jvanderberg/pico-stretch2/review3/pack_after/drc.md

| Severity | Type | Count |
|---|---|---|
| warning | lib_footprint_mismatch | 7 |
| warning | silk_over_copper | 1 |

## lib_footprint_mismatch (warning, 7)
- Footprint 'PinHeader_1x03_P2.54mm_Vertical' does not match copy in library 'Connector_PinH: Footprint J2 @ (160.35, 98.91)
- Footprint 'C_0603_1608Metric' does not match copy in library 'Capacitor_SMD': Footprint C40 @ (122.45, 101.60)
- Footprint 'C_0603_1608Metric' does not match copy in library 'Capacitor_SMD': Footprint C37 @ (118.86, 103.90)
- Footprint 'R_0402_1005Metric' does not match copy in library 'Resistor_SMD': Footprint R3 @ (119.99, 101.30)
- Footprint 'RCLAMP0521P_TCT_C3029033' does not match copy in library 'EasyEDA': Footprint D3 @ (118.05, 101.92)
- Footprint 'TYPE-C_16PIN_2MD_073' does not match copy in library 'EasyEDA': Footprint USB1 @ (113.56, 101.06)
- Footprint 'C_0402_1005Metric' does not match copy in library 'Capacitor_SMD': Footprint C39 @ (117.85, 103.08)

## silk_over_copper (warning, 1)
- Silkscreen clipped by solder mask: Segment of U3 on Top Silkscreen Layer @ (120.76, 102.00); Pad 2 [3V3] of C40 on Top Layer @ (121.67, 101.60)
