jvanderberg/pico-stretch2/images/pcb-layout-bottom.jpg

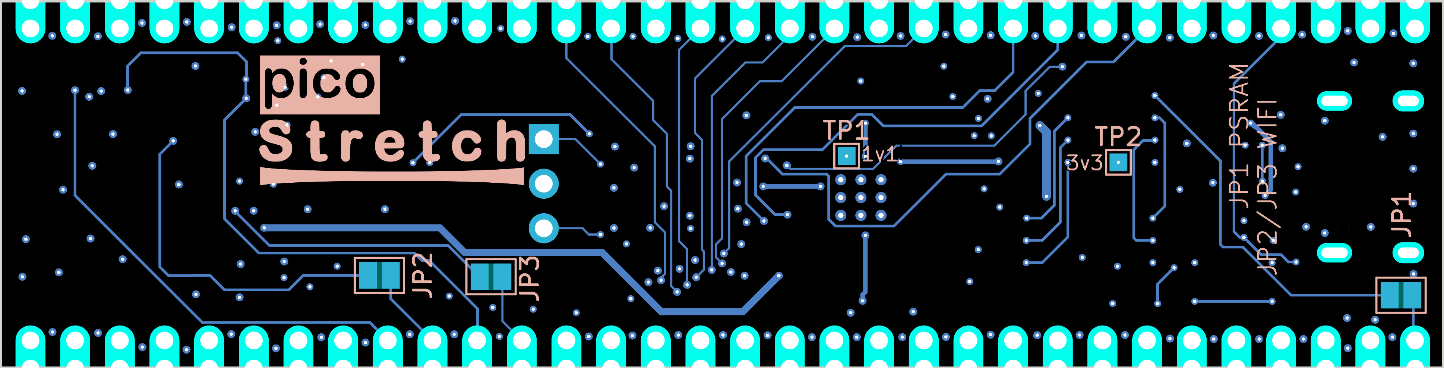
images/pcb-layout-bottom.jpg
