jvanderberg/pico-stretch2/images/pcb-layout-top.jpg

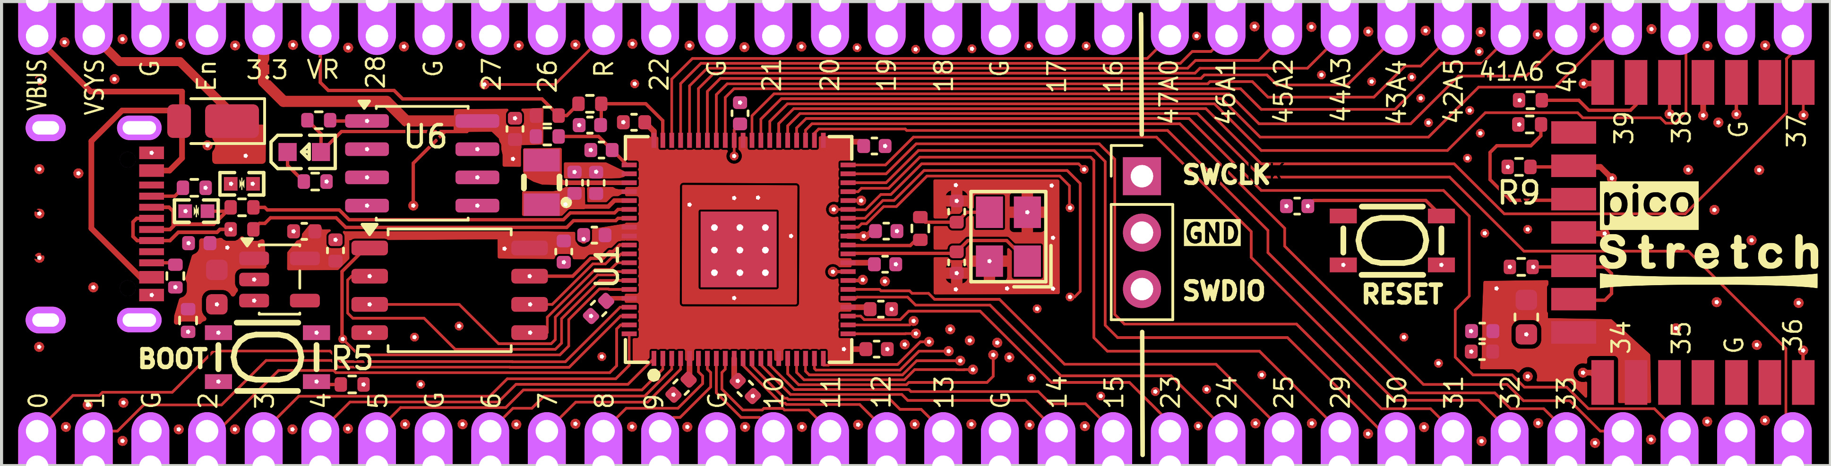
images/pcb-layout-top.jpg
