jvanderberg/pico-stretch2/review2/renders/in1_vreg.png

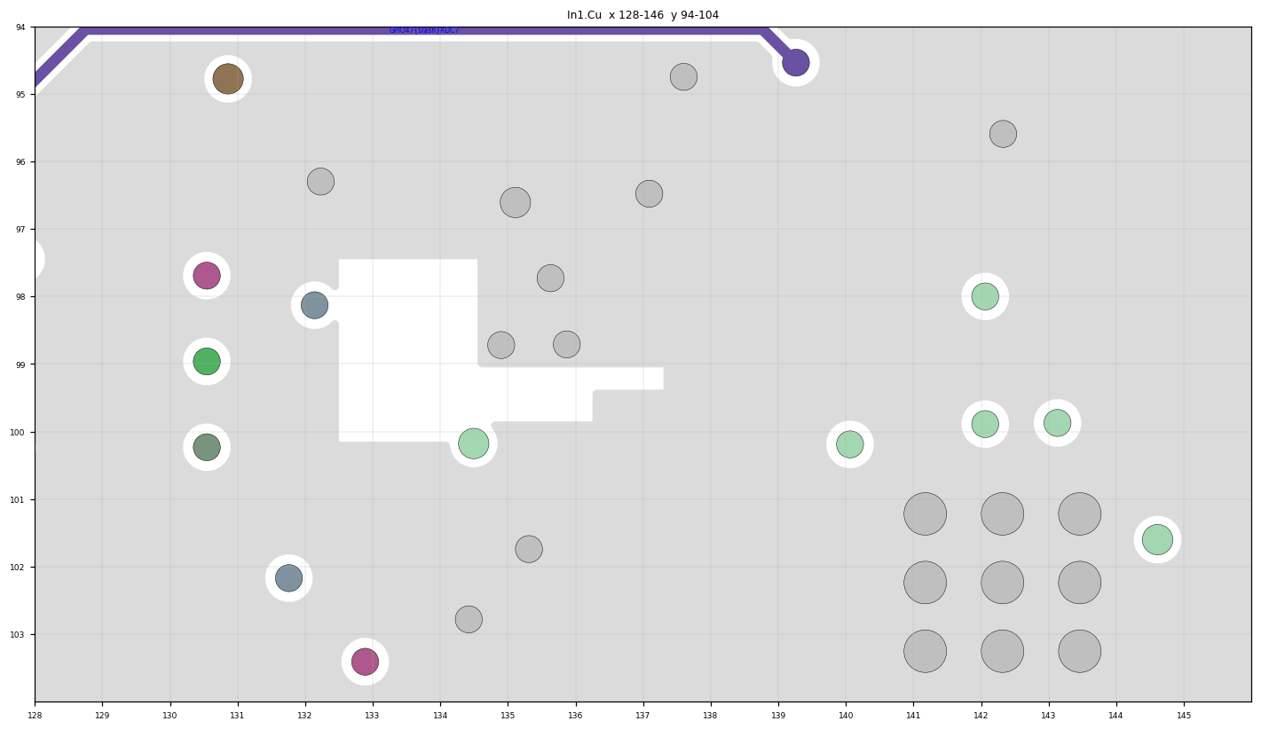
review2/renders/in1_vreg.png
