jvanderberg/pico-stretch2/review2/renders/silk_b_jp1_0.png

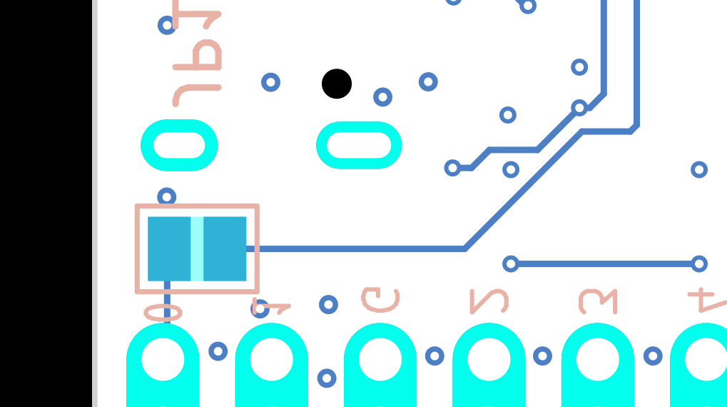
review2/renders/silk_b_jp1_0.png
