jvanderberg/pico-stretch2/review2/renders/silk_b_jp23.png

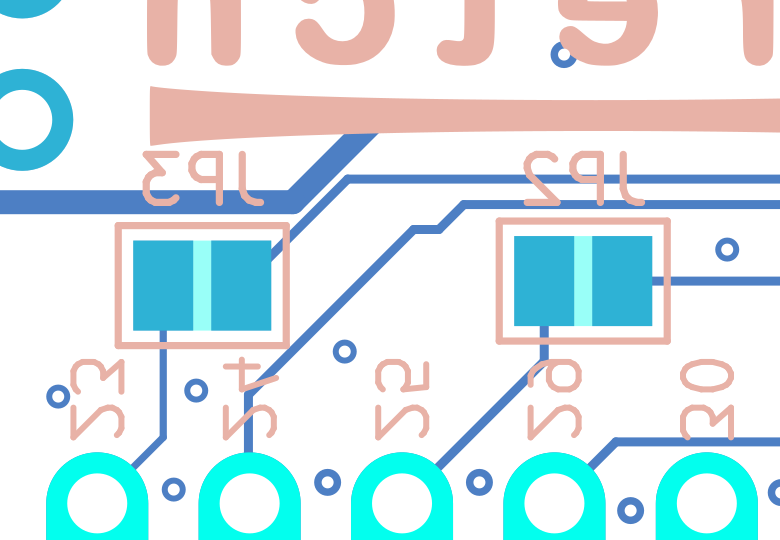
review2/renders/silk_b_jp23.png
