jvanderberg/pico-stretch2/review2/renders/silk_f_40A0.png

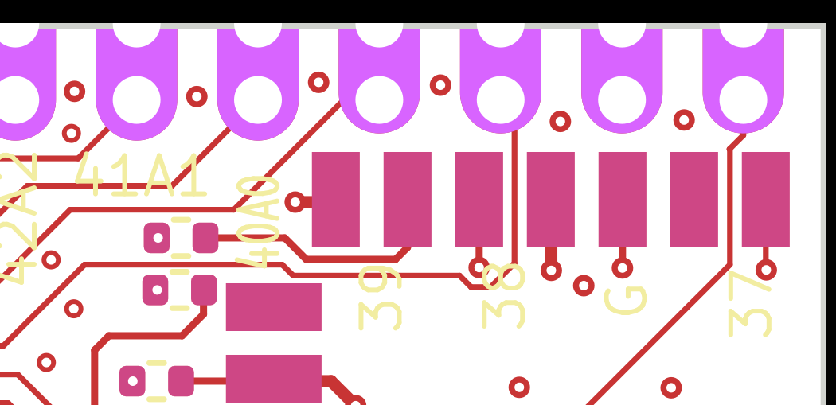
review2/renders/silk_f_40A0.png
