jvanderberg/pico-stretch2/review2/renders/silk_f_usb.png

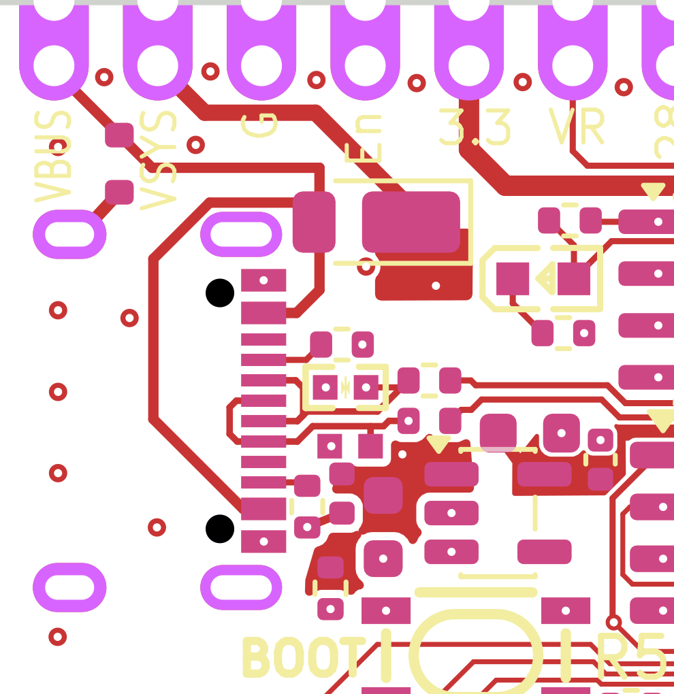
review2/renders/silk_f_usb.png
