jvanderberg/pico-stretch2/review2/renders/u1_p50_c13.png

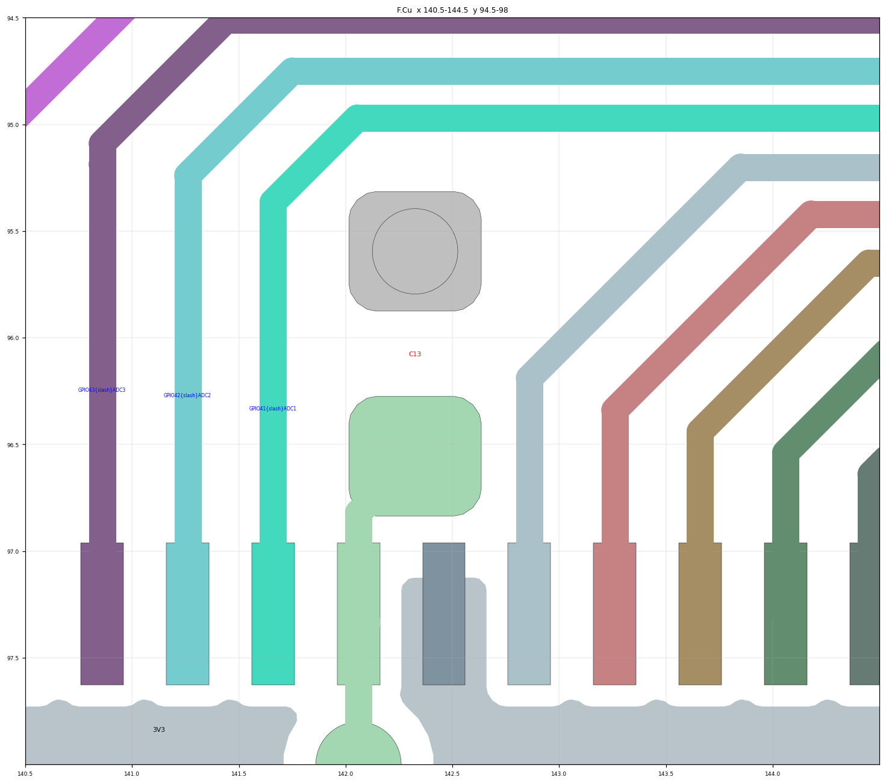
review2/renders/u1_p50_c13.png
