jvanderberg/pico-stretch2/review2/renders/u6_fcu.png

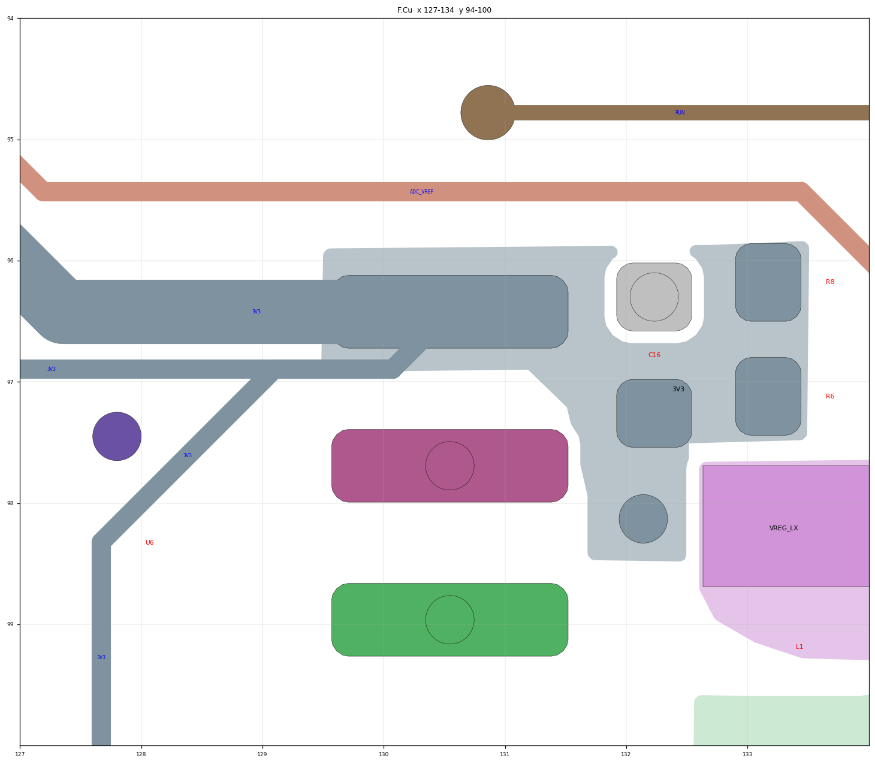
review2/renders/u6_fcu.png
