jvanderberg/pico-stretch2/review2/renders/usb_bcu.png

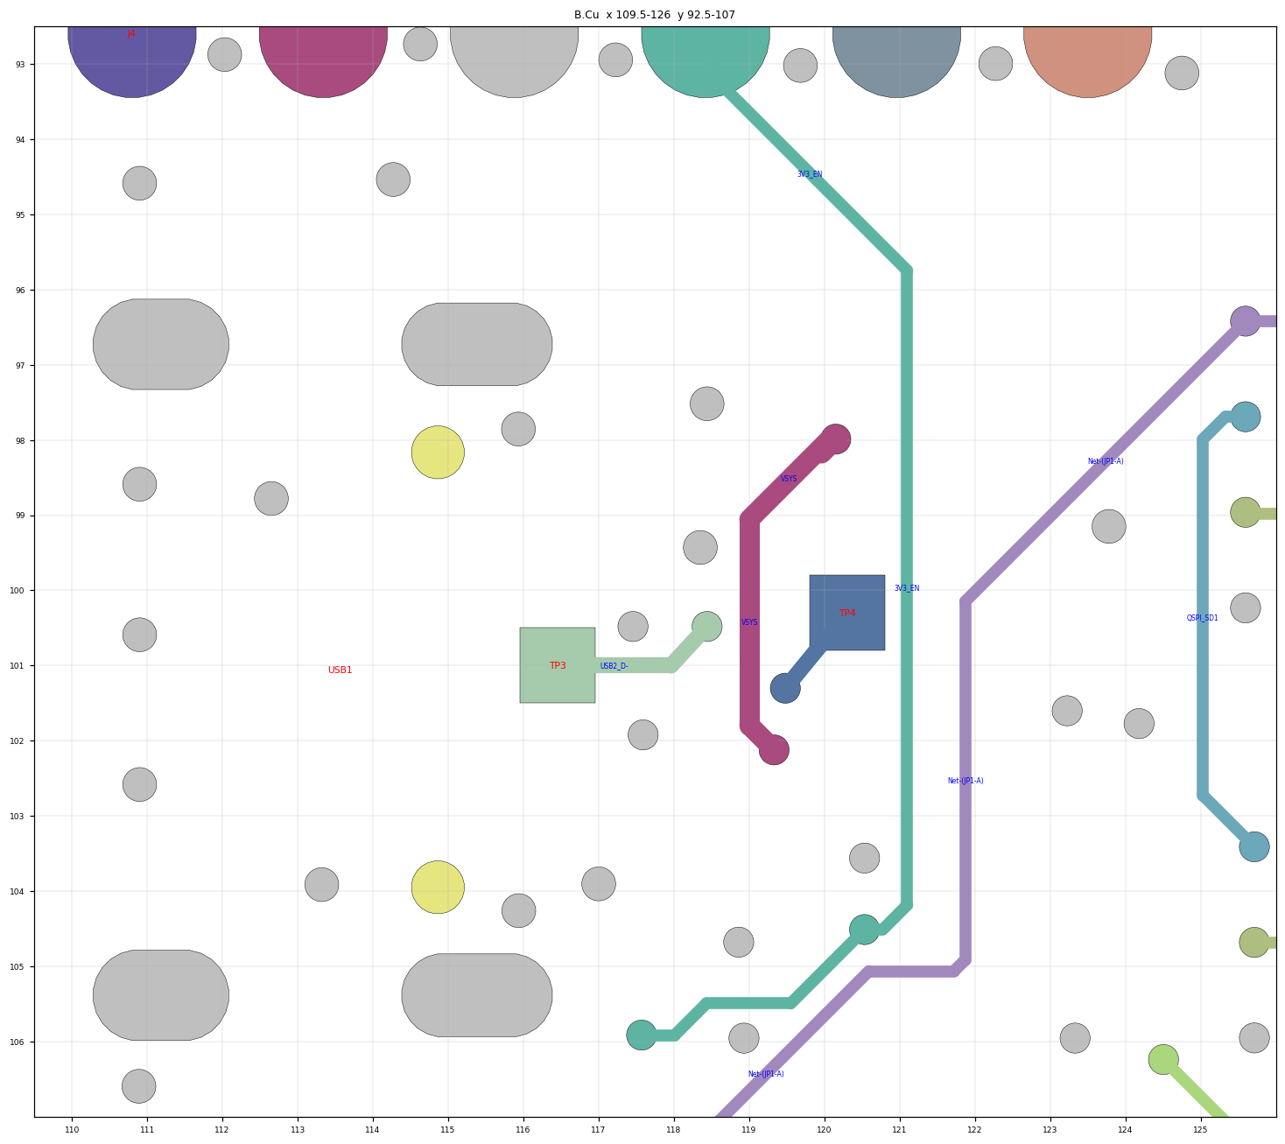
review2/renders/usb_bcu.png
