jvanderberg/pico-stretch2/review2/renders/usb_fcu.png

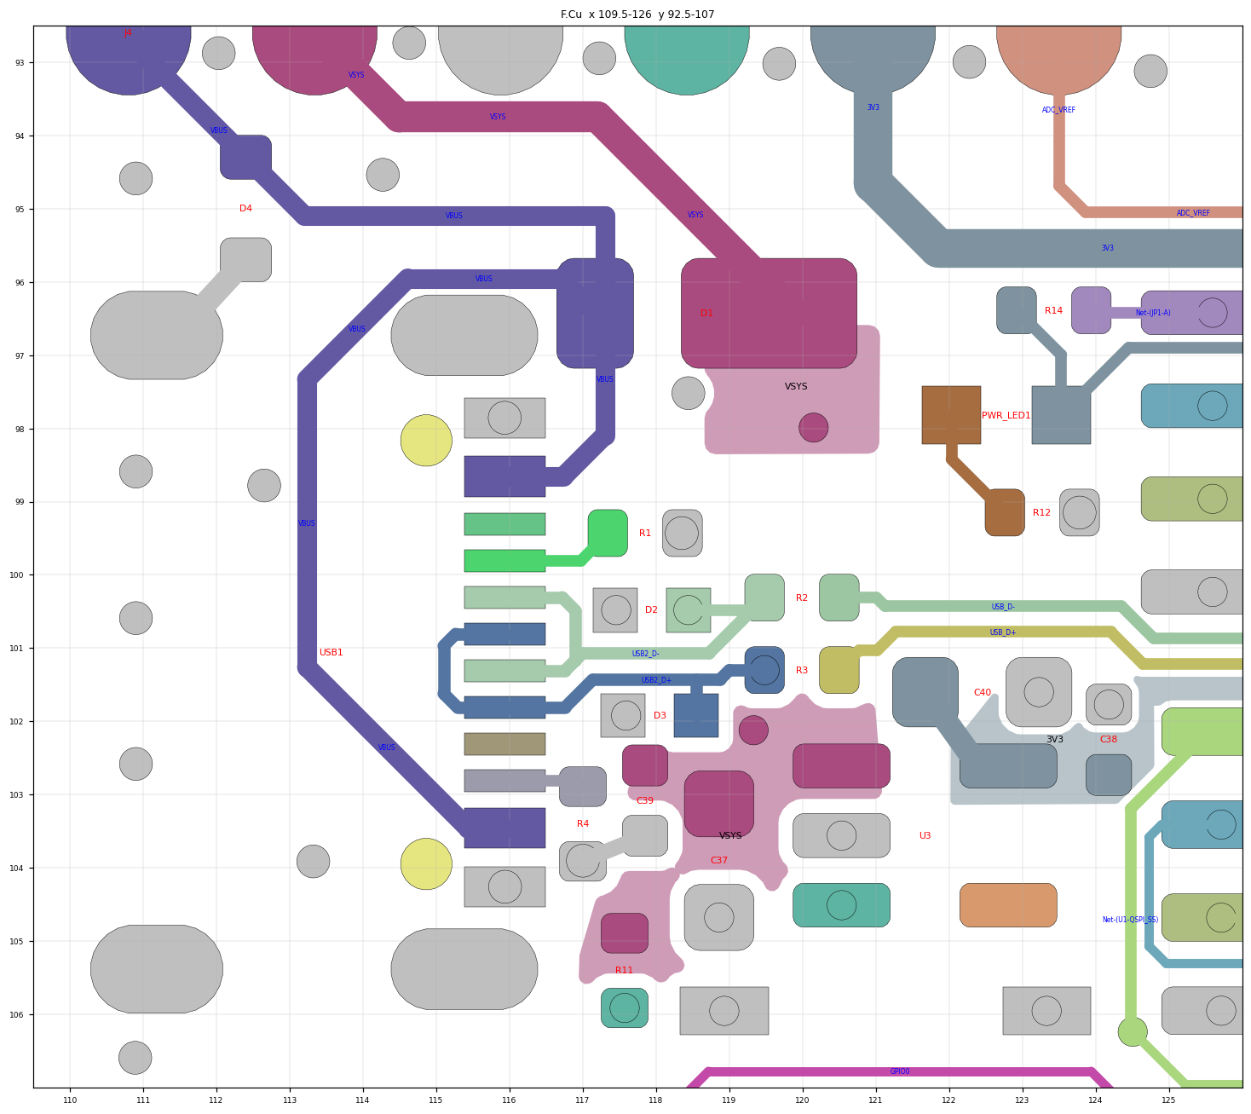
review2/renders/usb_fcu.png
