jvanderberg/pico-stretch2/review2/renders/usb_in1.png

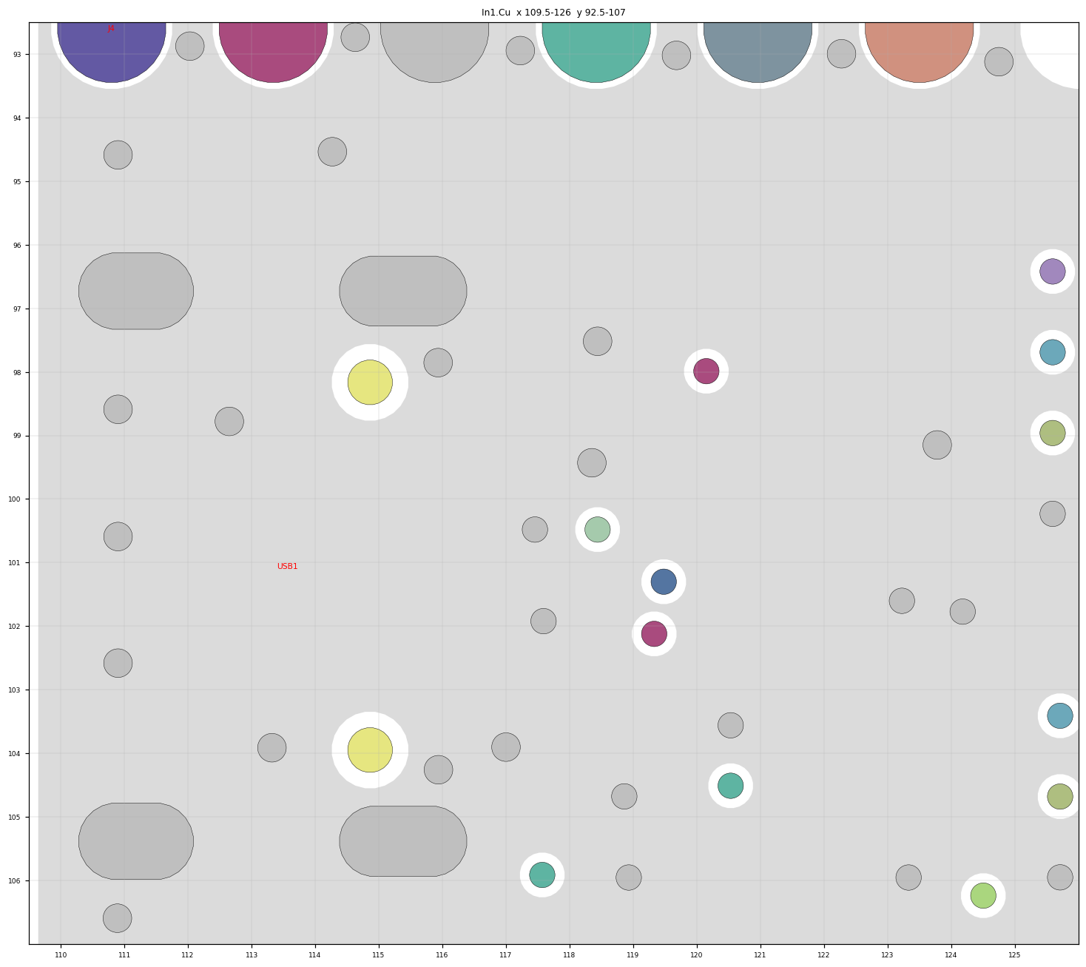
review2/renders/usb_in1.png
