jvanderberg/pico-stretch2/review2/renders/vreg_fcu.png

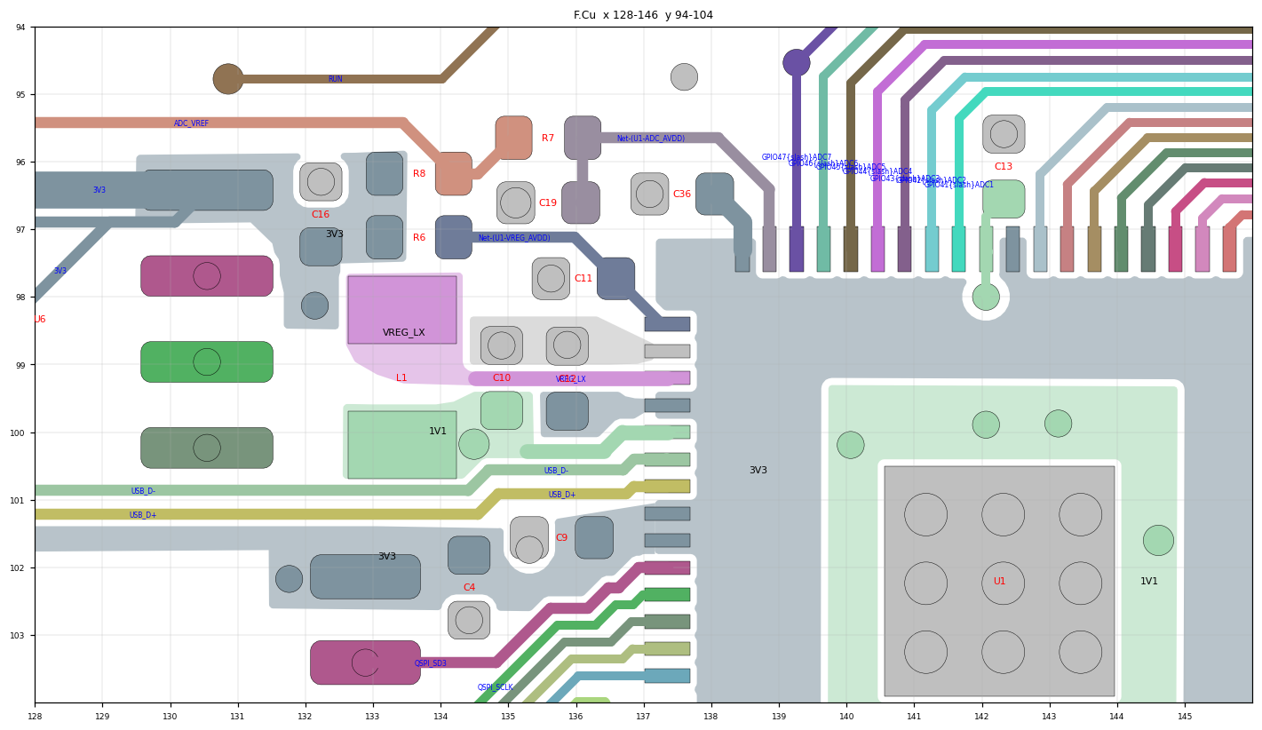
review2/renders/vreg_fcu.png
