jvanderberg/pico-stretch2/review3/pack/maps/gnd_return_inner_15.2um.png

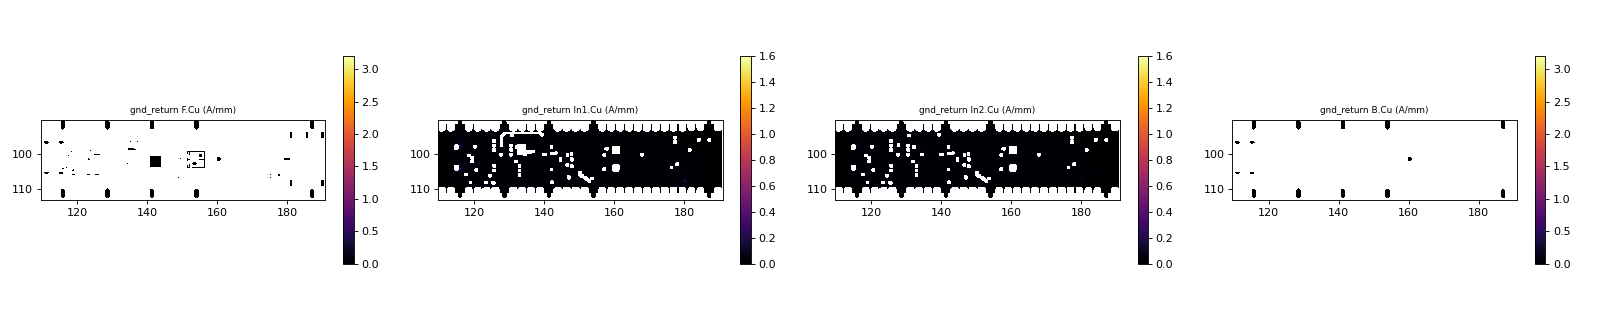
review3/pack/maps/gnd_return_inner_15.2um.png
