jvanderberg/pico-stretch2/review3/pack/maps/p1v1_inner_15.2um.png

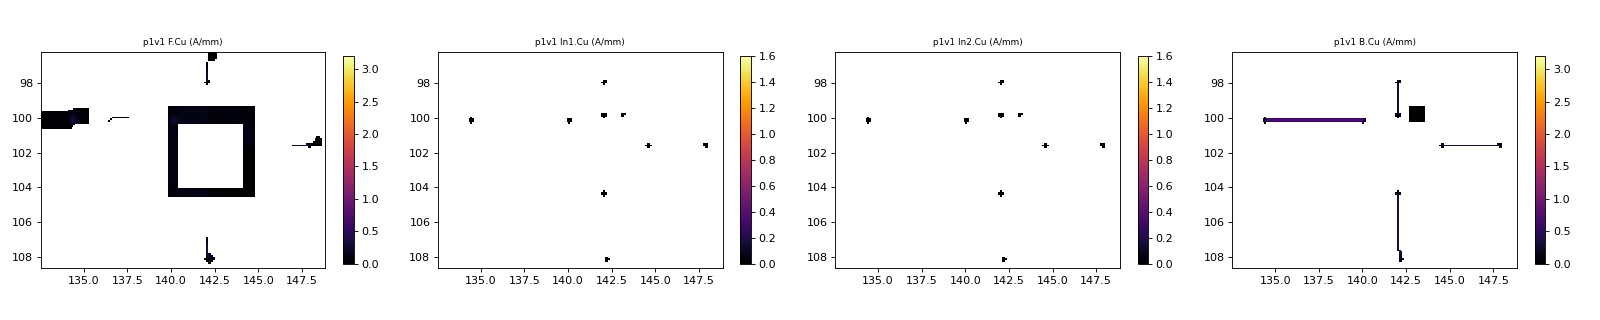
review3/pack/maps/p1v1_inner_15.2um.png
