jvanderberg/pico-stretch2/review3/pack/maps/p3v3_inner_15.2um.png

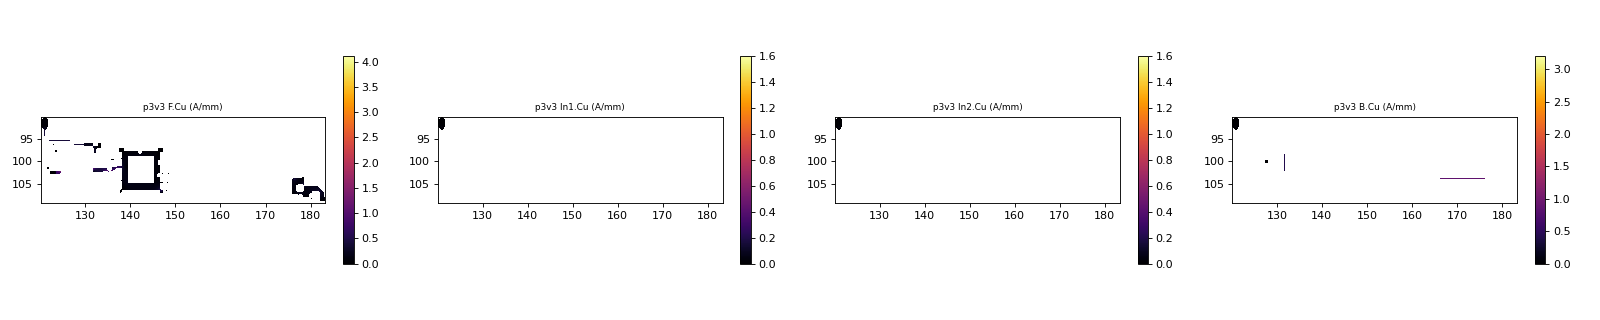
review3/pack/maps/p3v3_inner_15.2um.png
