jvanderberg/pico-stretch2/review3/pack/maps/thermal_radio_tx.png

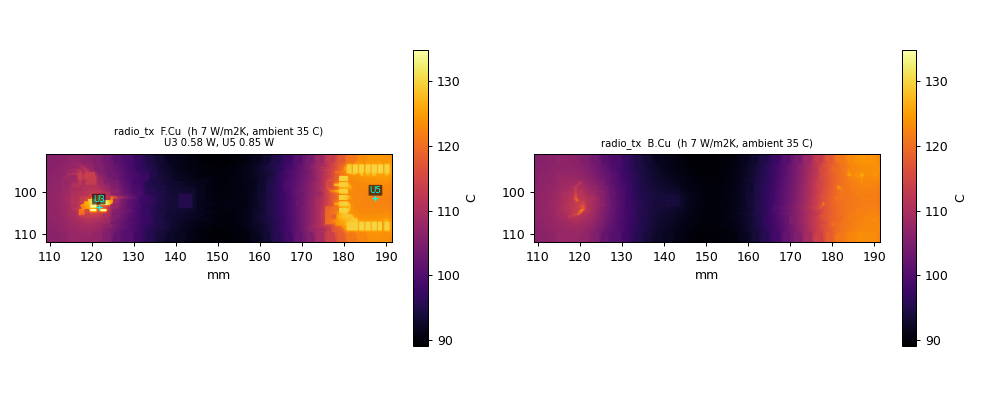
review3/pack/maps/thermal_radio_tx.png
