jvanderberg/pico-stretch2/review3/pack/maps/thermal_typical.png

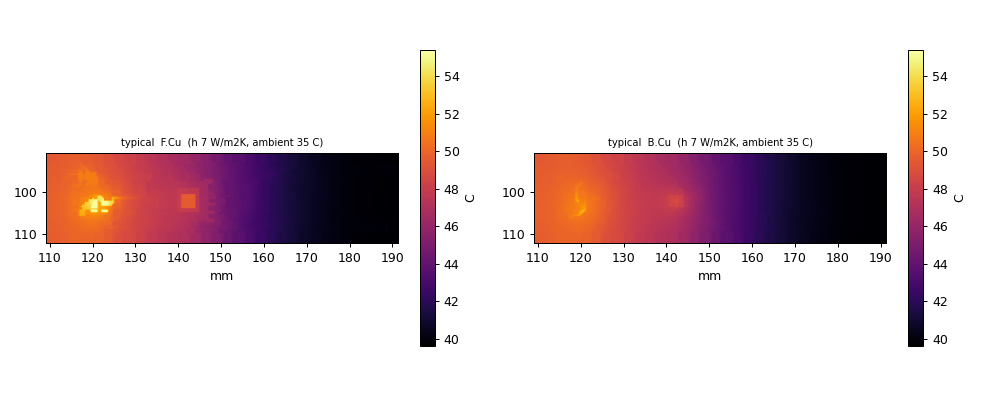
review3/pack/maps/thermal_typical.png
