jvanderberg/pico-stretch2/review3/pack/maps/vbus_inner_15.2um.png

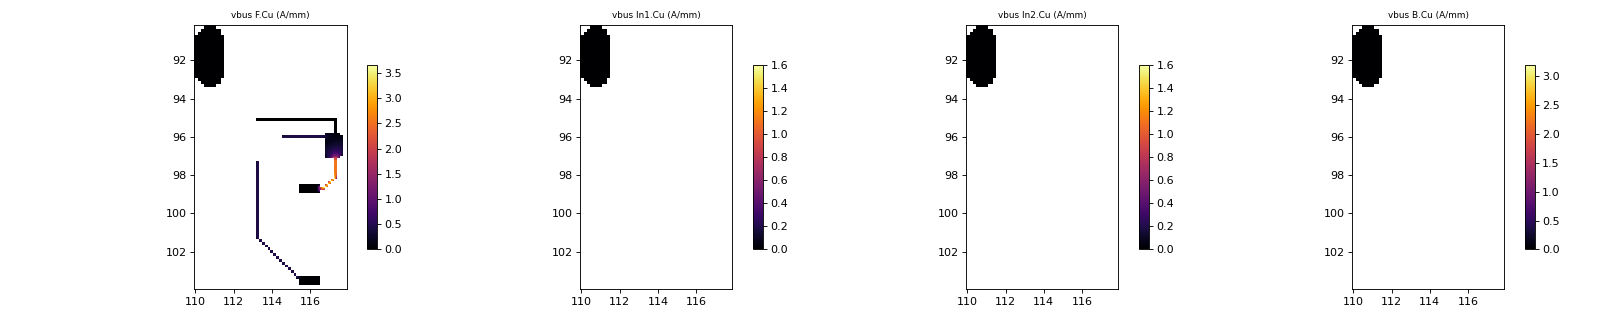
review3/pack/maps/vbus_inner_15.2um.png
