jvanderberg/pico-stretch2/review3/renders/bottom3d.png

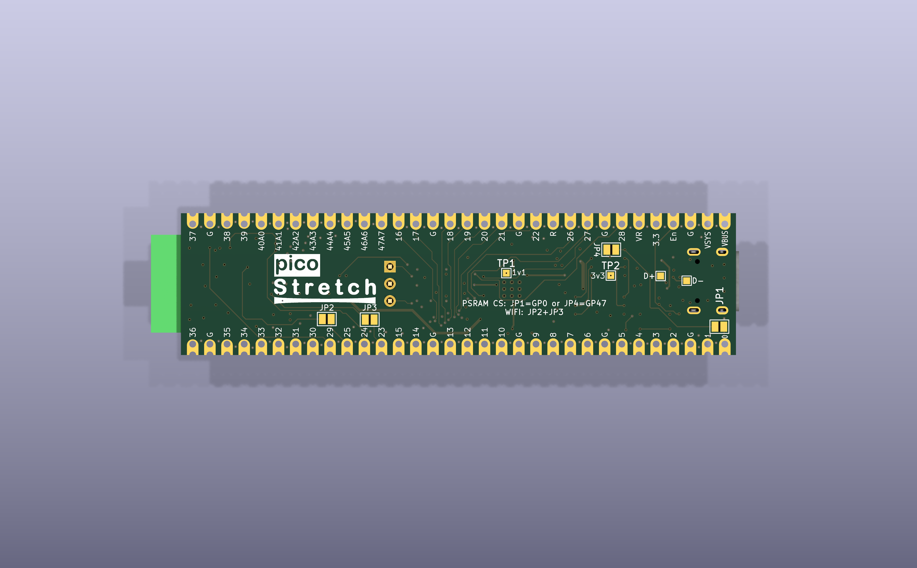
review3/renders/bottom3d.png
