jvanderberg/pico-stretch2/review3/renders/pico_tp_back.png

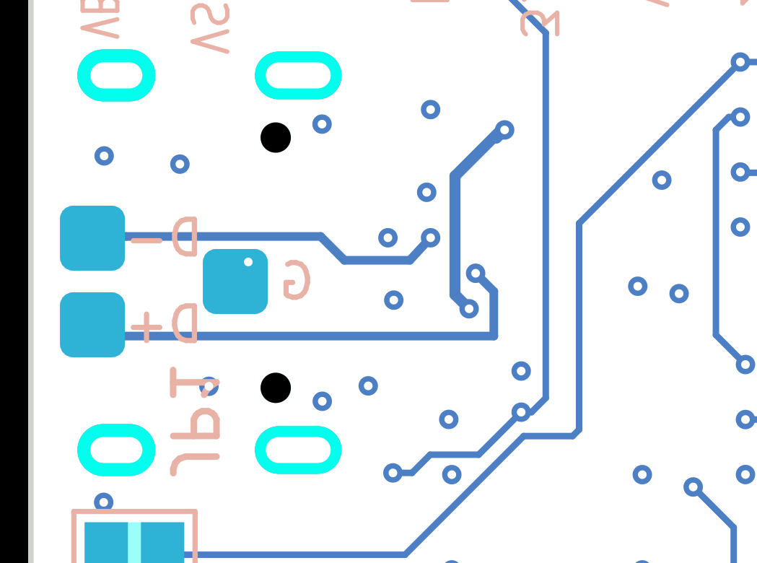
review3/renders/pico_tp_back.png
