jvanderberg/pico-stretch2/review3/renders/top3d.png

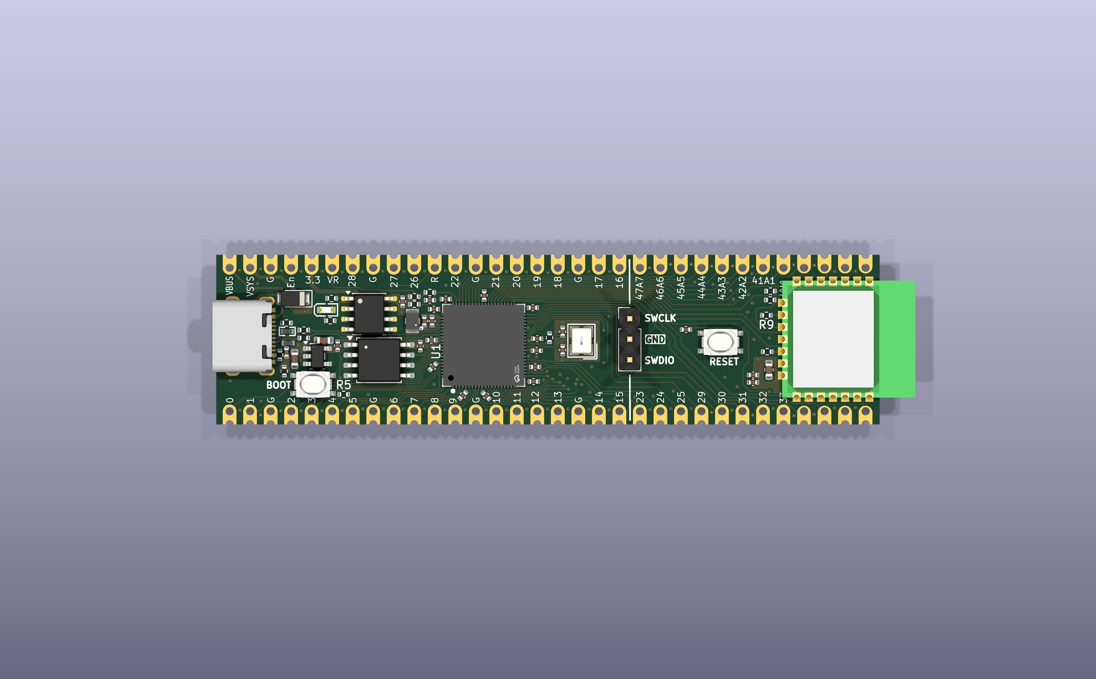
review3/renders/top3d.png
