jvanderberg/pico-stretch2/review3/renders/usb_end_bcu.png

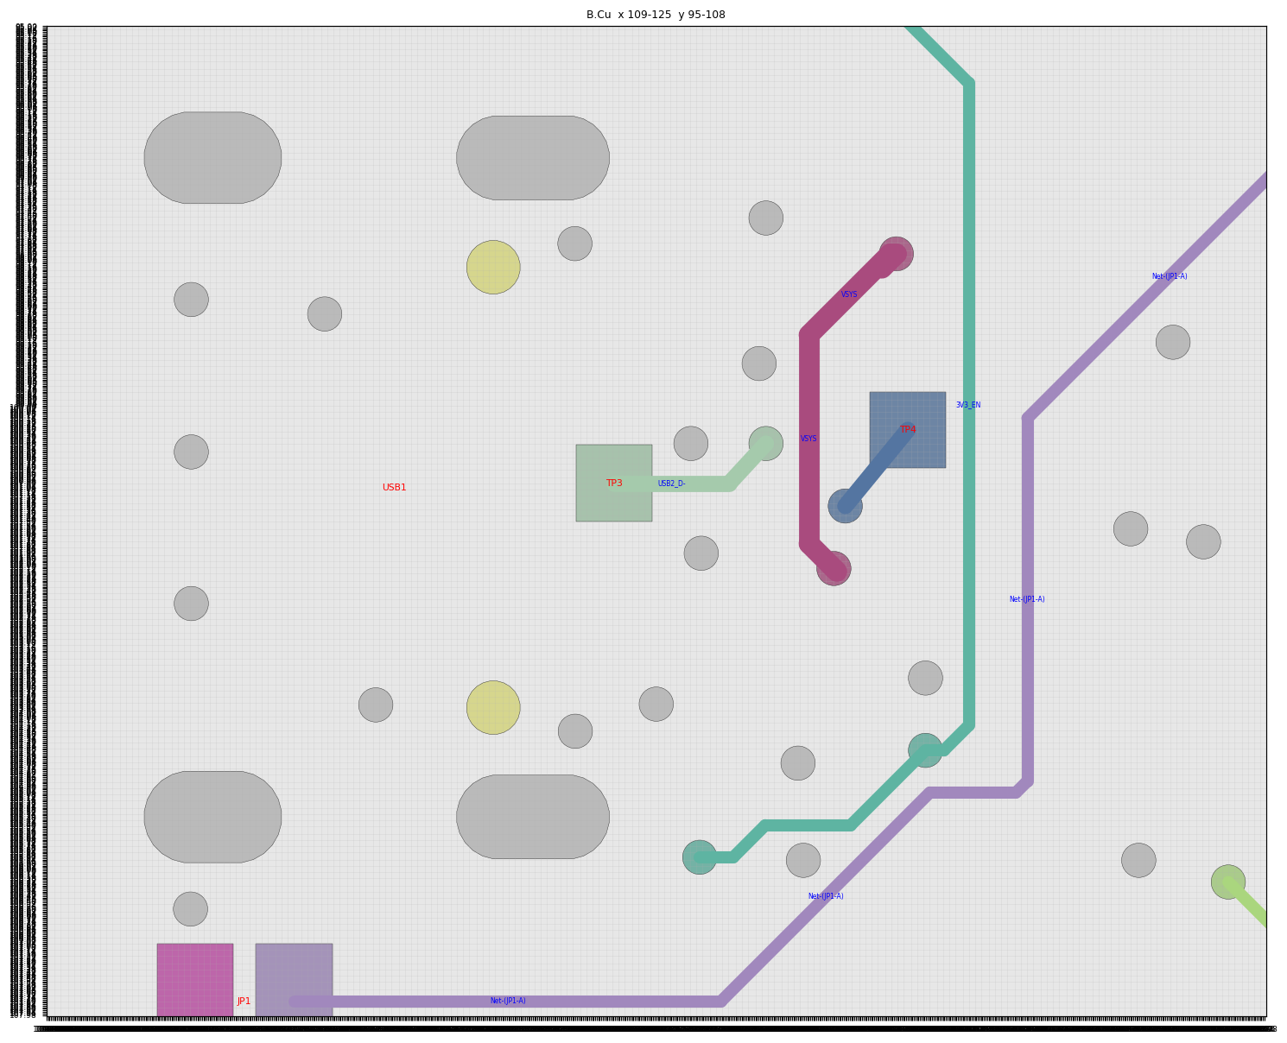
review3/renders/usb_end_bcu.png
