jvanderberg/pico-stretch2/review3/renders/usb_end_fcu.png

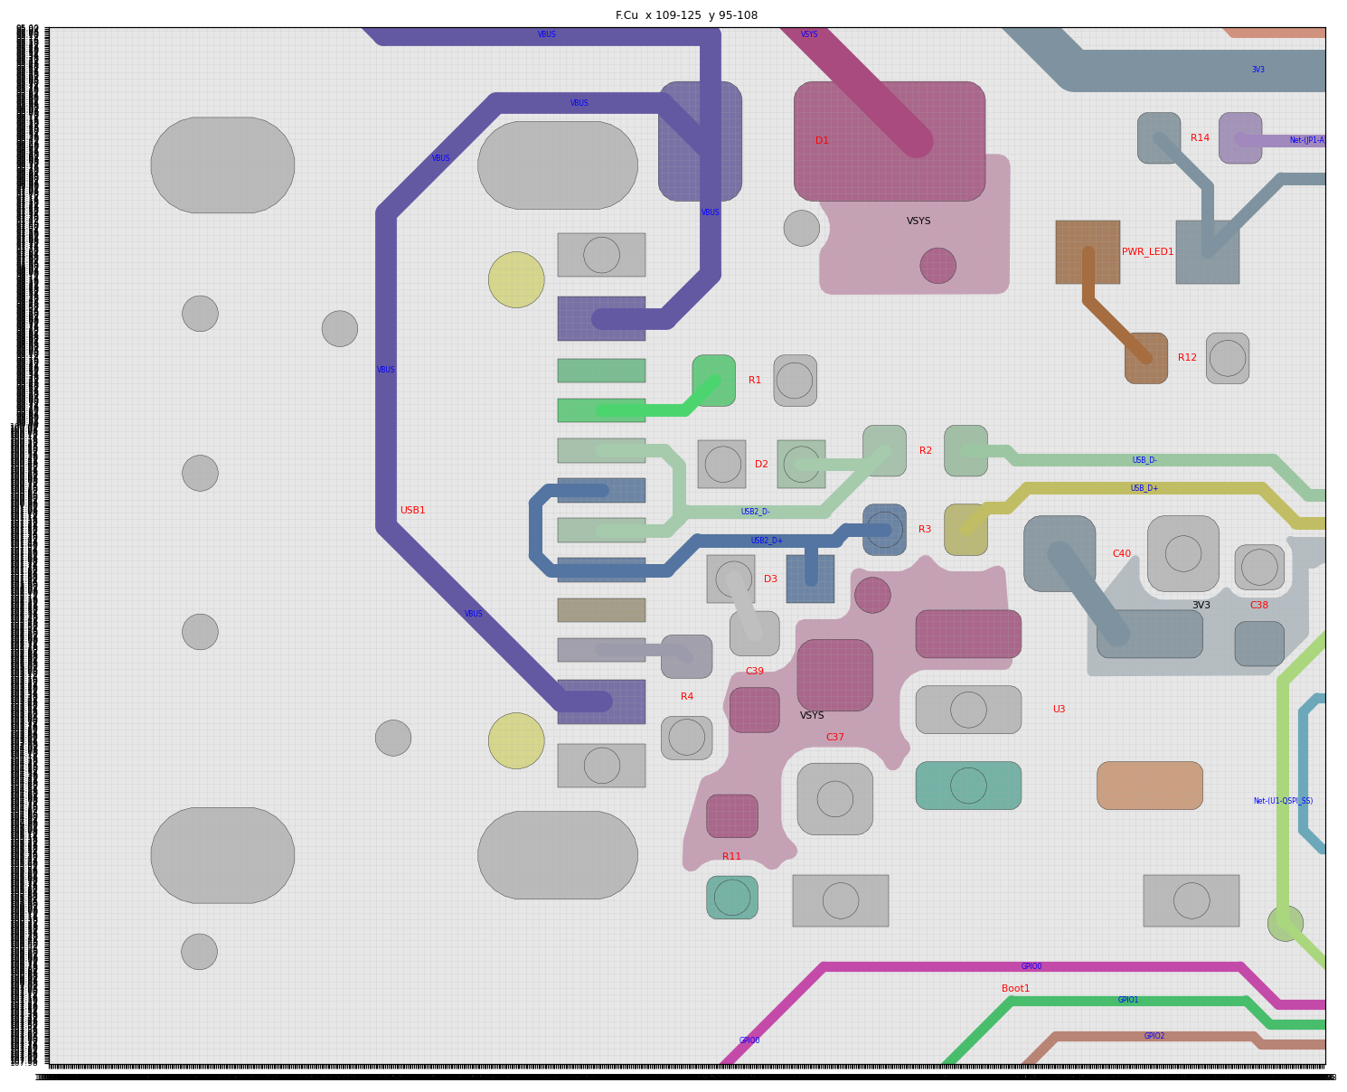
review3/renders/usb_end_fcu.png
