jvanderberg/pico-stretch2/review/renders/back_silk_L.png

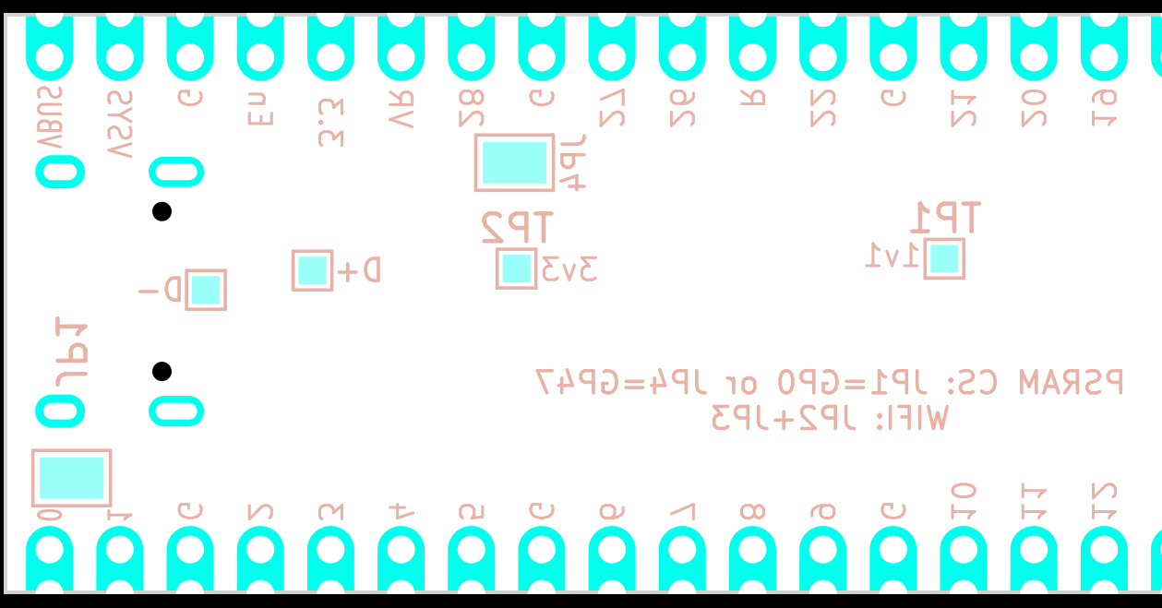
review/renders/back_silk_L.png
