jvanderberg/pico-stretch2/review/renders/back_silk_R.png

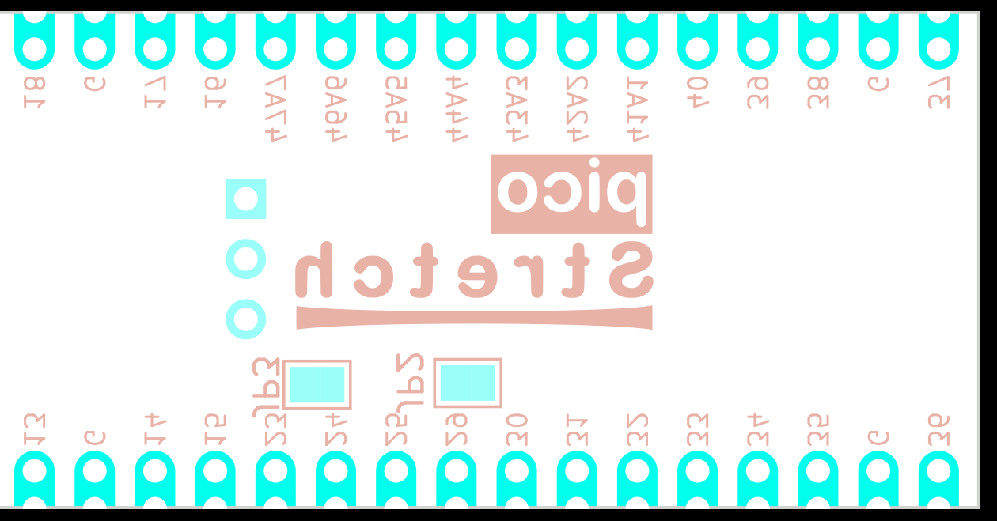
review/renders/back_silk_R.png
