jvanderberg/pico-stretch2/review/renders/front_silk_L.png

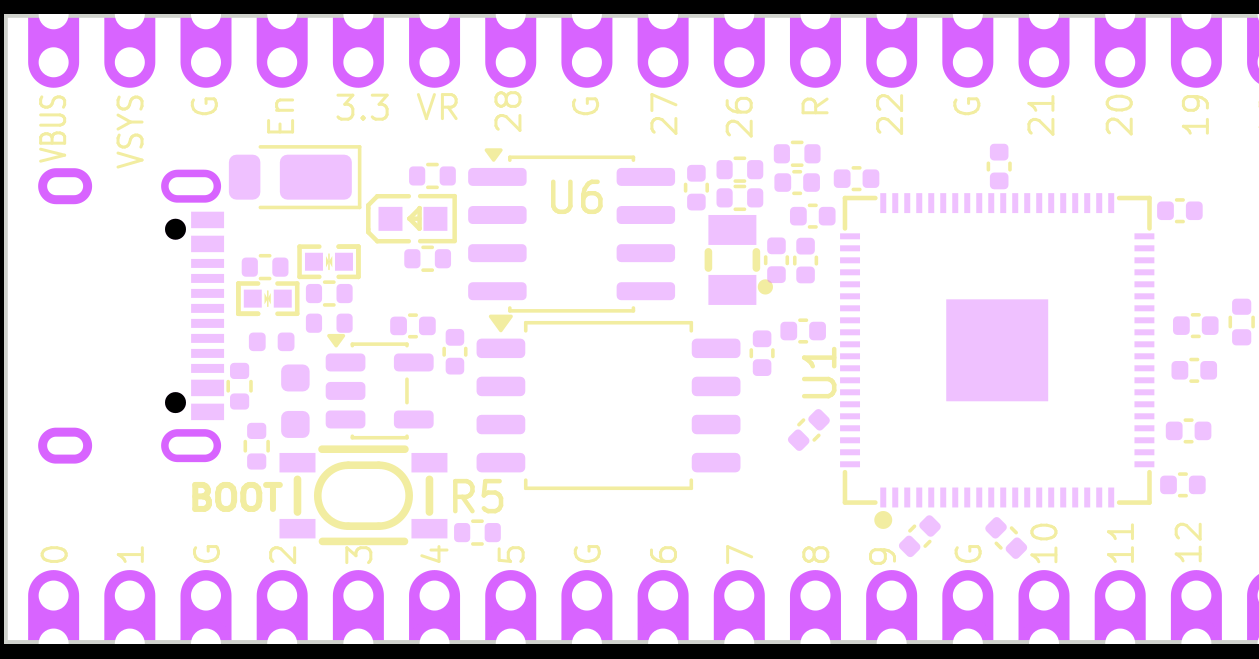
review/renders/front_silk_L.png
