jvanderberg/pico-stretch2/review/renders/front_silk_R.png

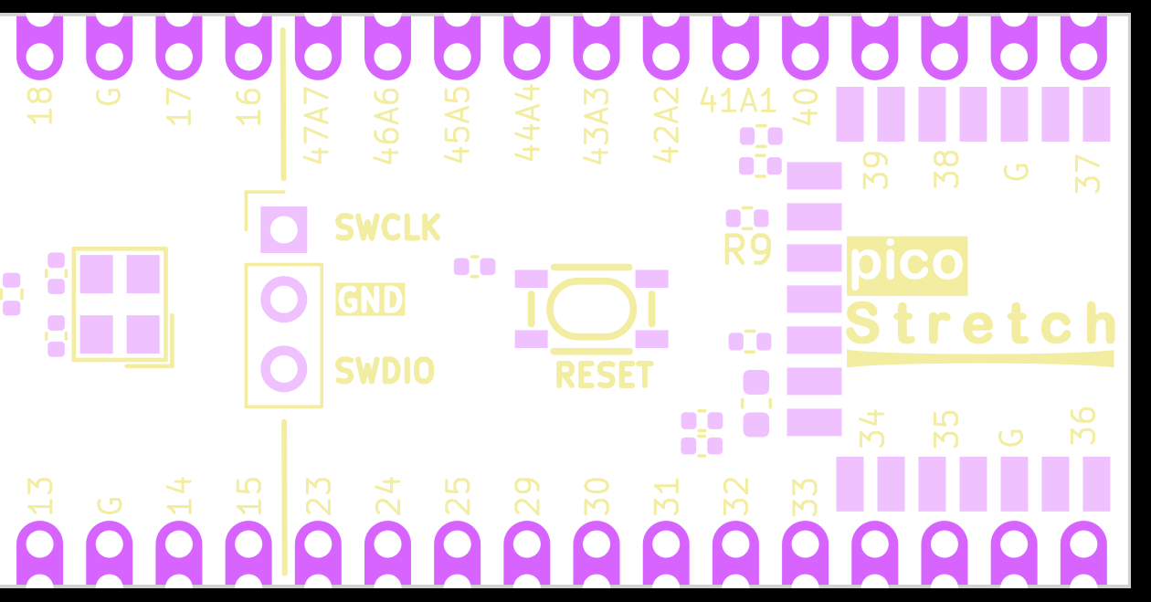
review/renders/front_silk_R.png
