jvanderberg/pico-stretch2/review/renders/in1_vreg_gpio47.png

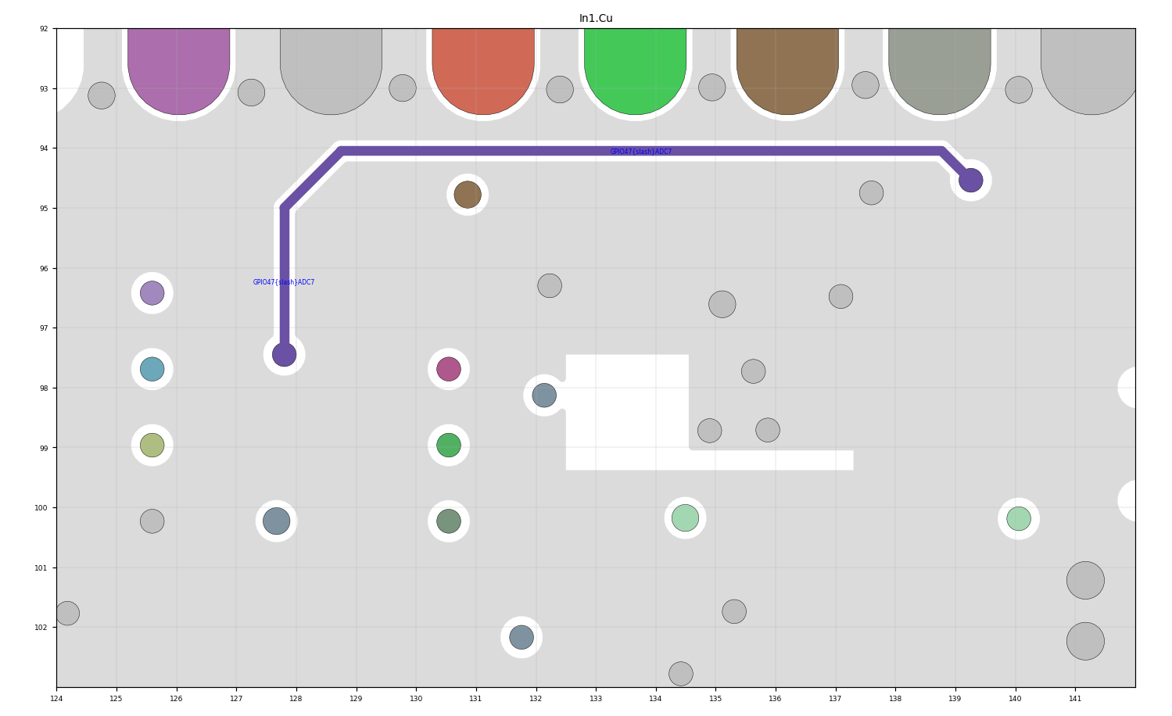
review/renders/in1_vreg_gpio47.png
