jvanderberg/pico-stretch2/review/renders/jp23.png

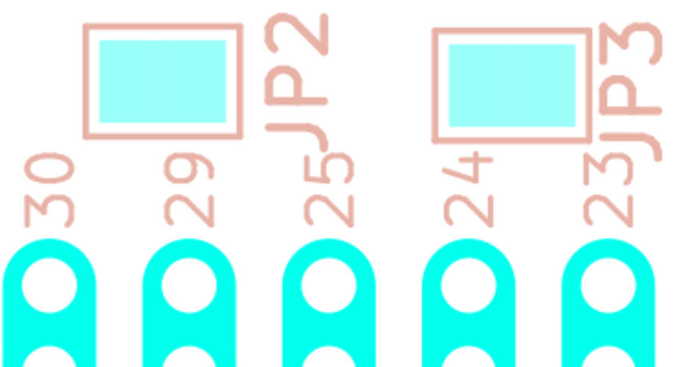
review/renders/jp23.png
