jvanderberg/pico-stretch2/review/renders/usb_bcu.png

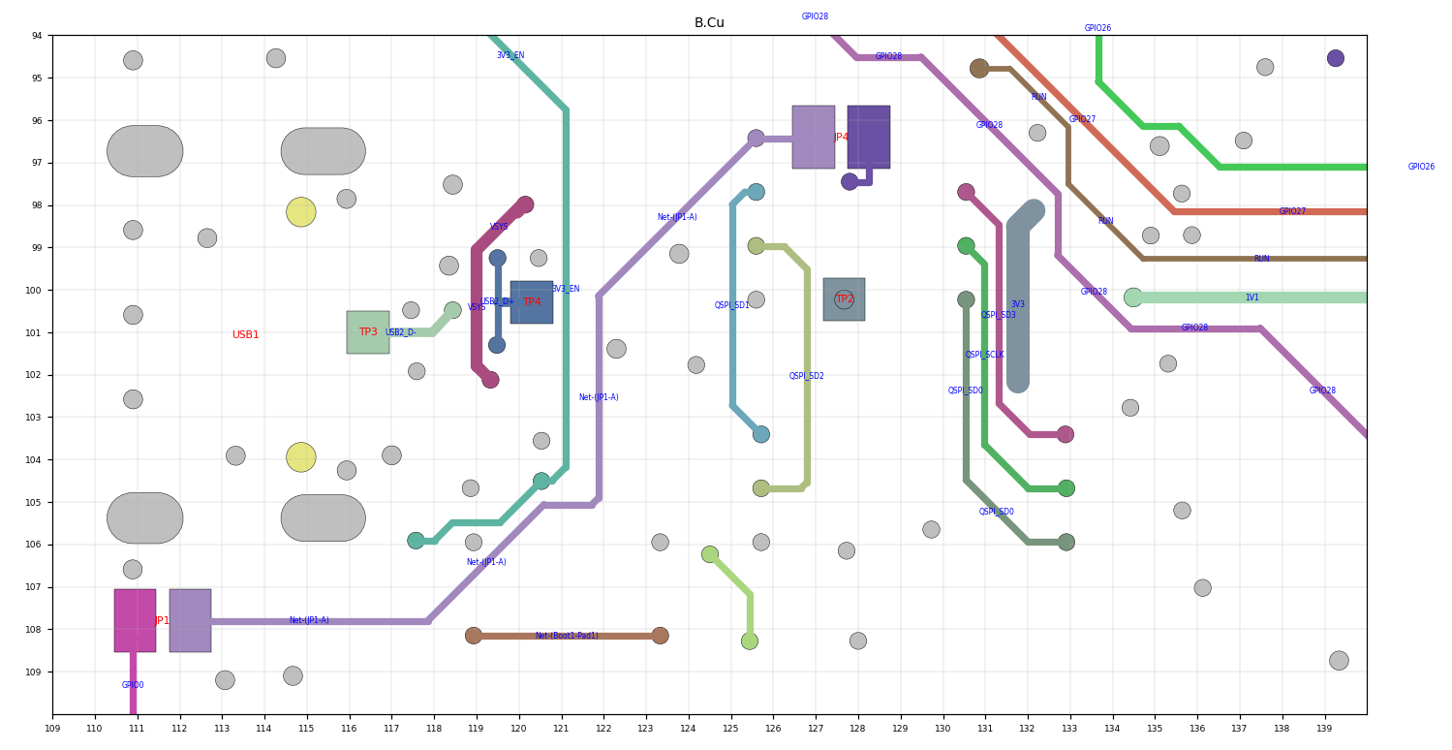
review/renders/usb_bcu.png
