jvanderberg/pico-stretch2/review/renders/usb_fcu.png

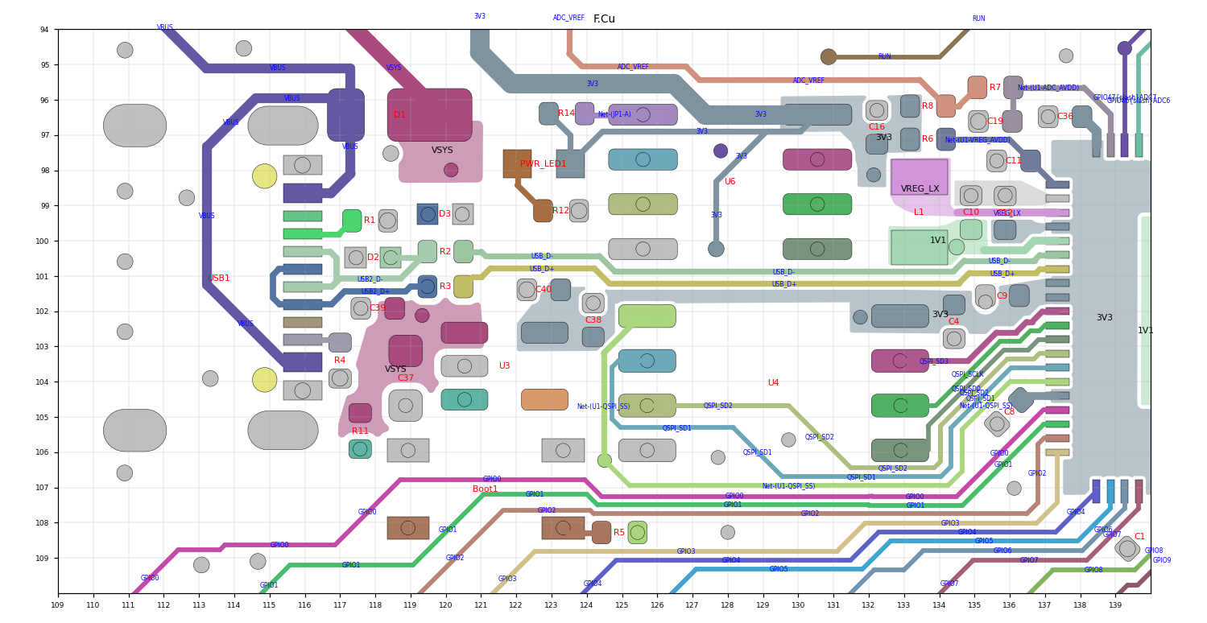
review/renders/usb_fcu.png
