jvanderberg/pico-stretch2/review/renders/vreg_fcu.png

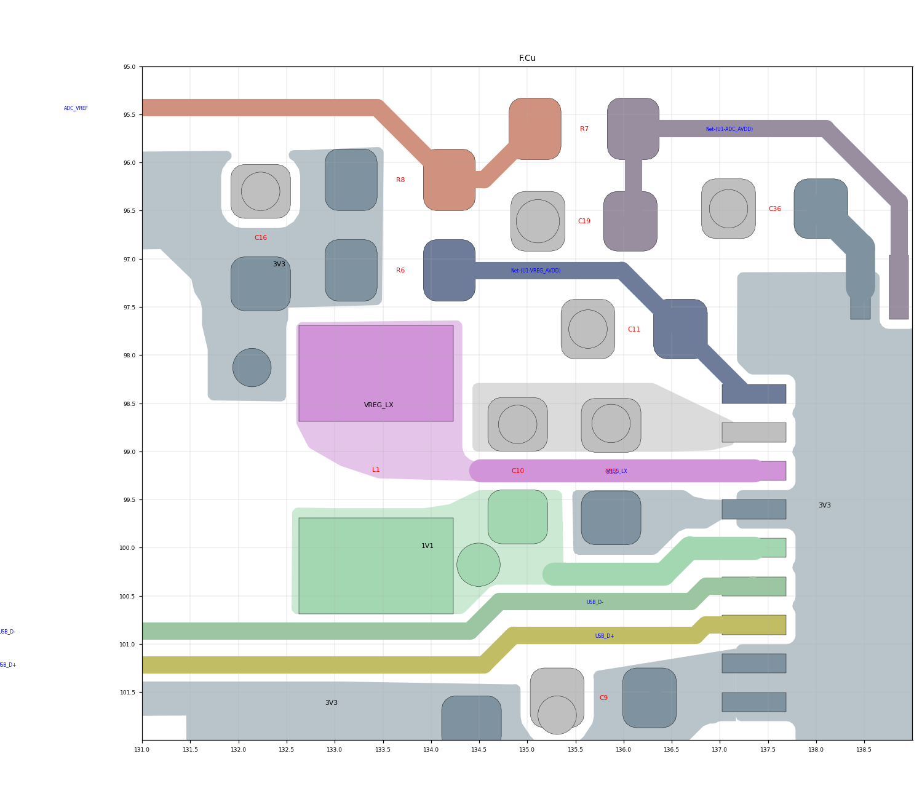
review/renders/vreg_fcu.png
