jvanderberg/pico-stretch2/production/pico-stretch2-bom.csv

Comment | Designator | Footprint | JLCPCB Part #
K2-1808SN-A4SW | Boot1,Reset1 | K2-1808SN-A4SW | C92589
100nF / CL05B104KO5NNNC | C1,C3,C4,C5,C6,C7,C8,C9,C13,C15,C16,C21,C22,C23,C36,C38,C39 | C_0402_1005Metric | C1525
4.7uF | C2,C10,C11,C12,C19 | C_0402_1005Metric | C23733
15pF | C17,C18 | C_0402_1005Metric | C1548
CL10A475KO8NNNC | C24 | C_0603_1608Metric | C19666
10uF | C37,C40 | C_0603_1608Metric | C19702
DFLS130L-7 | D1 | D_PowerDI-123 | C110493
RCLAMP0521P_TCT_C3029033 | D2,D3 | RCLAMP0521P_TCT_C3029033 | C3029033
Conn_01x03_Pin | J2 | PinHeader_1x03_P2.54mm_Vertical
AOTA-B201610S3R3-101-T | L1 | AOTA-B201610S3R3-101-T | C42411119
KT-0603R | PWR_LED1 | KT-0603R | C2286
5.1kΩ | R1,R4 | R_0402_1005Metric | C25905
33Ω | R2,R3,R6 | R_0402_1005Metric | C25105
1kΩ | R5,R14,R28 | R_0402_1005Metric | C11702
1Ω | R7 | R_0402_1005Metric | C25086
200Ω | R8 | R_0402_1005Metric | C25087
10kΩ | R9,R10,R16 | R_0402_1005Metric | C25744
100kΩ | R11 | R_0402_1005Metric | C25741
2kΩ | R12 | R_0402_1005Metric | C4109
470Ω | R15 | R_0402_1005Metric | C25117
RP2350B_C42415655 | U1 | RP2350B_C42415655 | C42415655
ME6217C33M5G | U3 | SOT-23-5 | C427602
W25Q128JVSIQTR | U4 | SOIC-8_5.3x5.3mm_P1.27mm | C97521
TYPE-C_16PIN_2MD_073 | USB1 | TYPE-C_16PIN_2MD_073 | C2765186
ABM8-272-T3_C20625731 | X1 | ABM8-272-T3_C20625731 | C20625731
