jvanderberg/pico-stretch2/production/bom.csv

Designator | Footprint | Quantity | Value | LCSC Part #
BOOT1, RESET1 | K2-1808SN-A4SW | 2 | K2-1808SN-A4SW | C92589
C1, C13, C16, C2, C21, C22, C23, C3, C36, C4, C6, C7, C8 | 0402 | 13 | 100nF | C1525
C10, C11, C12, C19, C5 | 0402 | 5 | 4.7uF | C23733
C15, C9 | 0402 | 2 | 100nF | C14663
C17, C18 | 0402 | 2 | 15pF | C1548
C24 | 0603 | 1 | CL10A475KO8NNNC | C19666
C37 | 0603 | 1 | 10uF | C19702
C38, C39 | 0402 | 2 | CL05B104KO5NNNC | C1525
C40 | 0402 | 1 | CL05A106MQ5NUNC | C15525
D1 | D_PowerDI-123 | 1 | DFLS130L-7 | C110493
D2, D3 | RCLAMP0521P_TCT_C3029033 | 2 | RCLAMP0521P_TCT_C3029033 | C3029033
J2 | PinHeader_1x03_P2.54mm_Vertical | 1 | Conn_01x03_Pin
J4 | Castellated_Pad_64 | 1 | Conn_01x64_Castellated_Pads
L1 | AOTA-B201610S3R3-101-T | 1 | AOTA-B201610S3R3-101-T | C42411119
PWR_LED1 | KT-0603R | 1 | KT-0603R | C2286
R1, R4 | 0402 | 2 | 5.1kΩ | C25905
R10, R14, R16, R9 | 0402 | 4 | 10kΩ | C25744
R11 | 0402 | 1 | 100kΩ | C25741
R12 | 0402 | 1 | 2kΩ | C4109
R15 | 0402 | 1 | 470Ω | C25117
R2, R3, R6 | 0402 | 3 | 33Ω | C25105
R28, R5 | 0402 | 2 | 1kΩ | C11702
R7 | 0402 | 1 | 1Ω | C25086
R8 | 0402 | 1 | 200Ω | C25087
TP1, TP2, TP3, TP4 | TestPoint_Pad_1.0x1.0mm | 4 | TestPoint
U1 | RP2350B_C42415655 | 1 | RP2350B_C42415655 | C42415655
U3 | SOT-23-5 | 1 | ME6217C33M5G | C427602
U4 | SOIC-8_5.3x5.3mm_P1.27mm | 1 | W25Q128JVSIQTR | C97521
U5 | rpi_rmc20452t | 1 | RPI Radio Module 2
USB1 | TYPE-C_16PIN_2MD_073 | 1 | TYPE-C_16PIN_2MD_073 | C2765186
X1 | ABM8-272-T3_C20625731 | 1 | ABM8-272-T3_C20625731 | C20625731
