jvanderberg/pico-stretch2/pico-stretch2.kicad_pcb

## KiCad design pico-stretch2.kicad_pcb (2026-10-31)

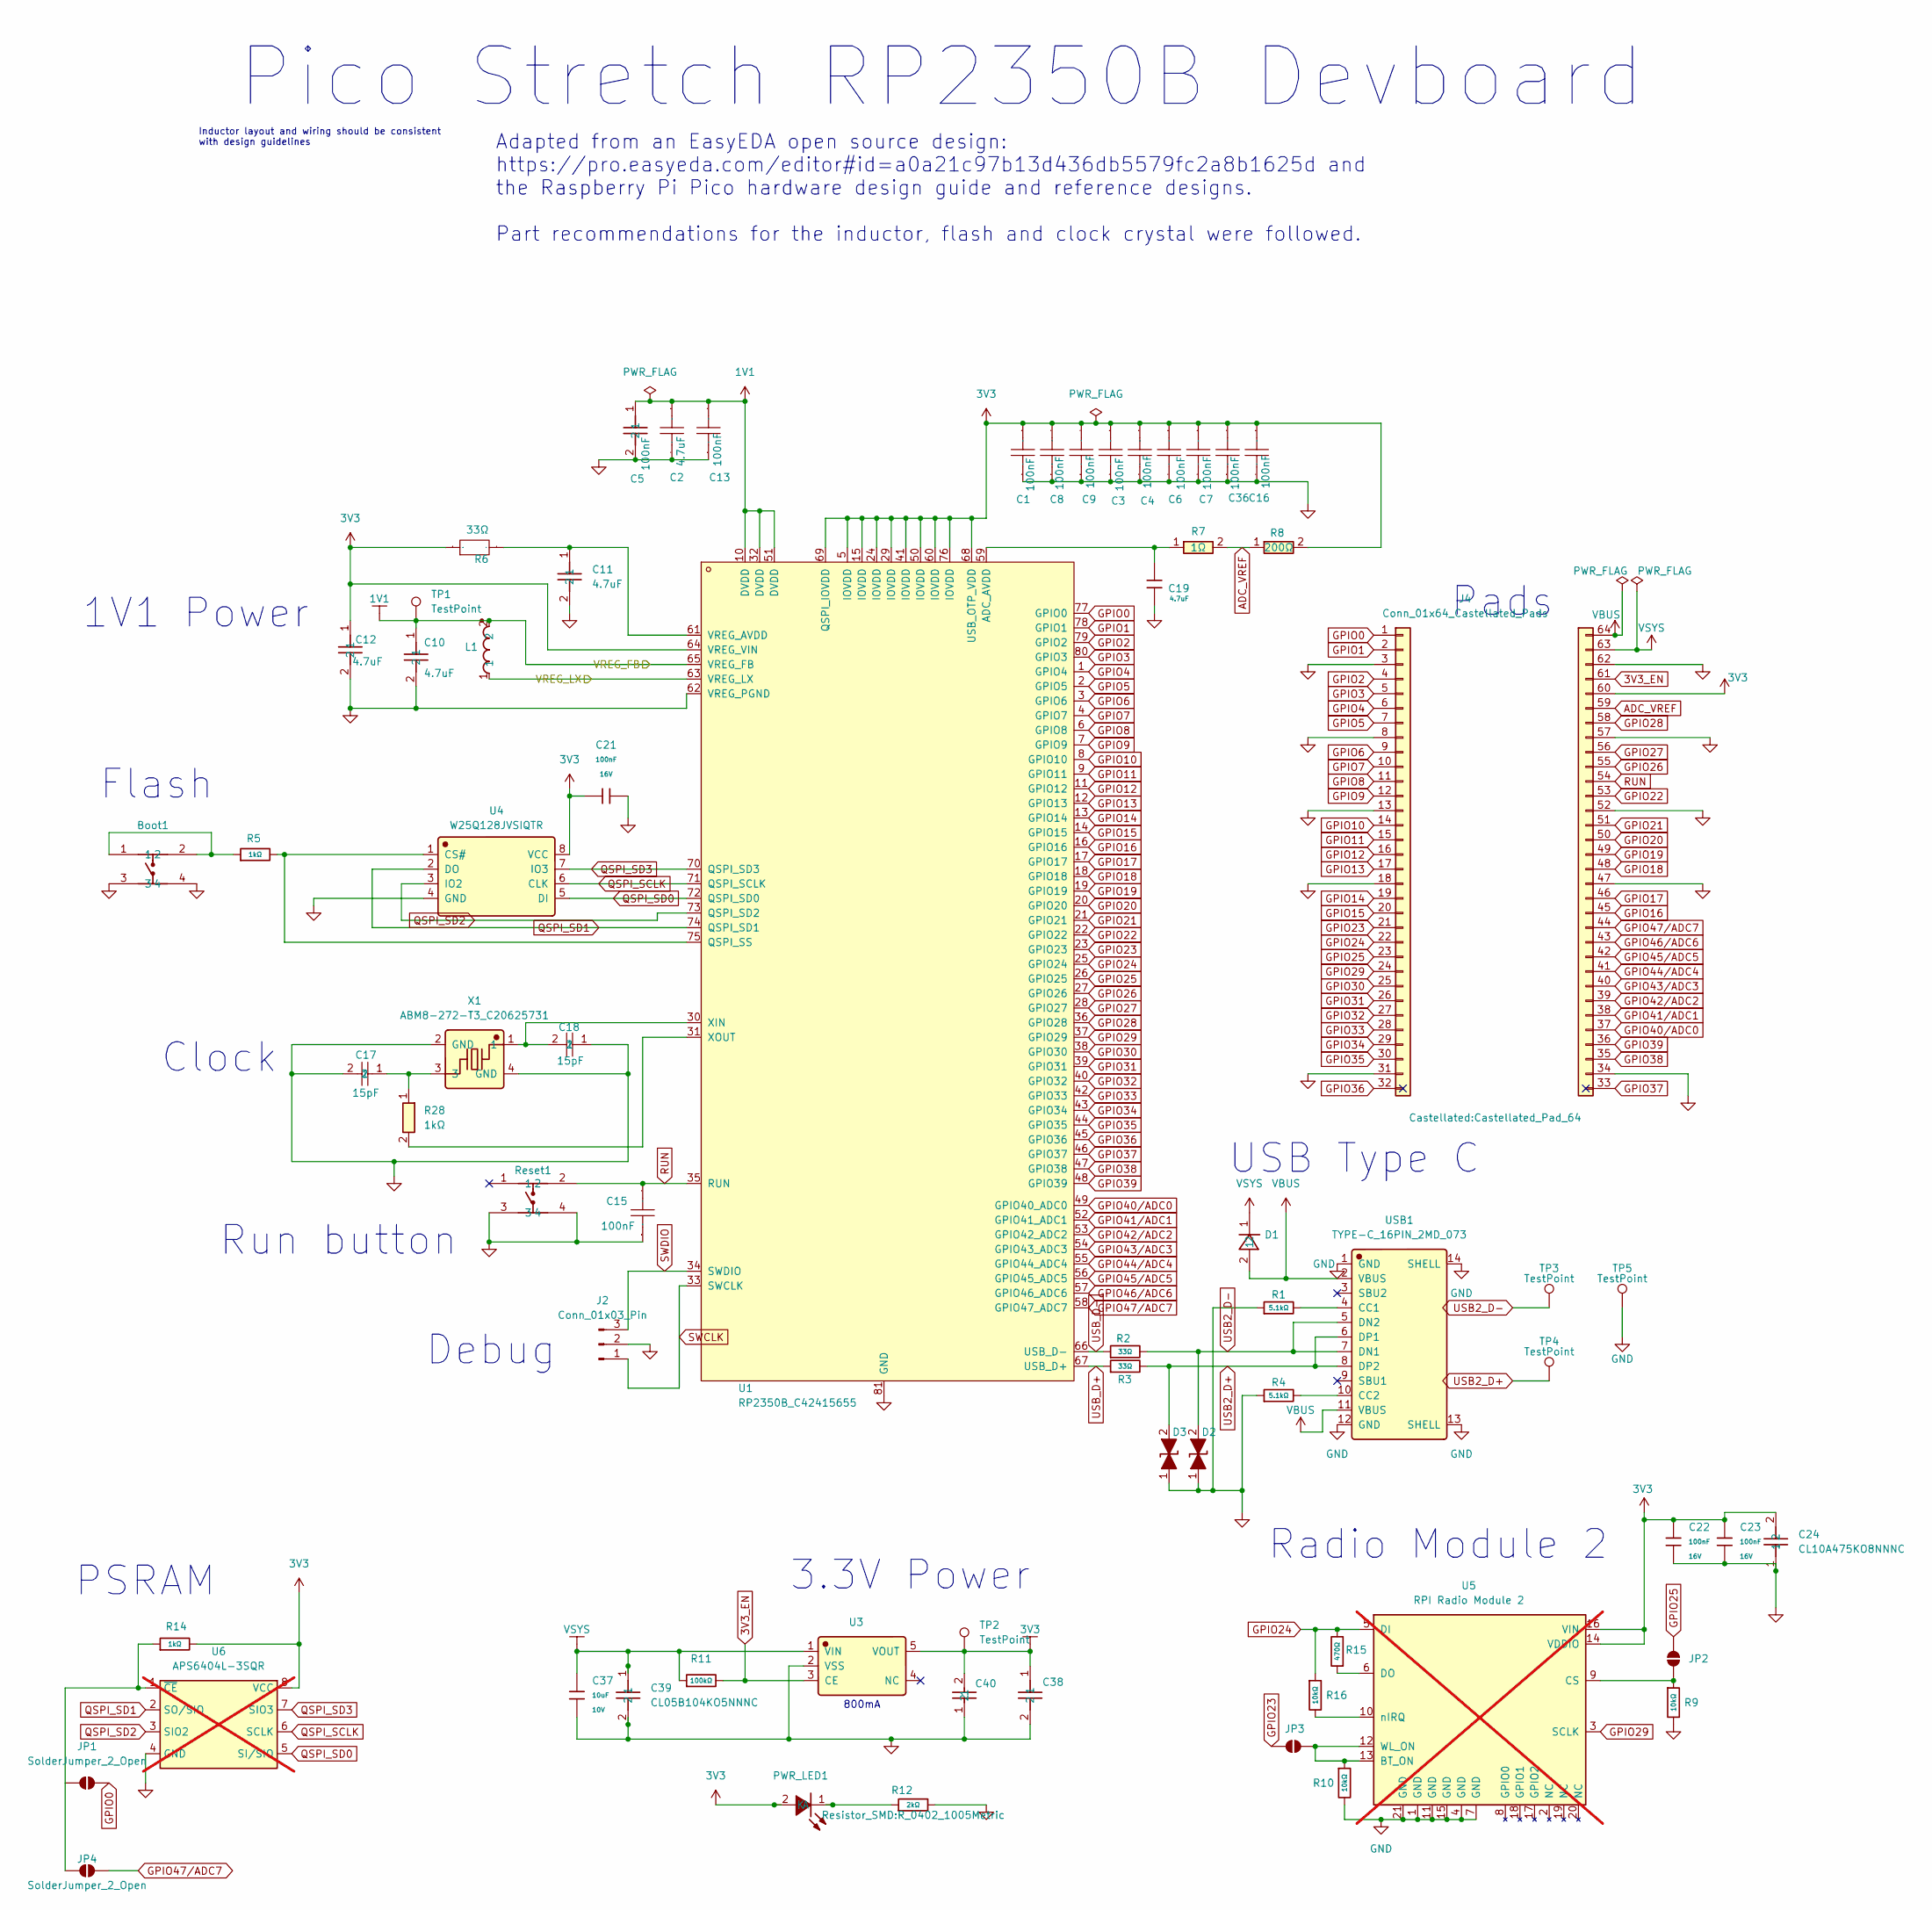
[picture p38: schematic pico-stretch2.kicad_sch]

Parts:
Boot1: K2-1808SN-A4SW; Manufacturer Part K2-1808SN-A4SW-01; LCSC C92589
C1, C3, C4, C6, C7, C8, C9, C13, C15, C16, C36: 100nF; C_0402_1005Metric; Manufacturer Part CL05B104KO5NNNC; LCSC Part Name 100nF ±10% 16V
C2, C10, C11, C12: 4.7uF; C_0402_1005Metric; Manufacturer Part CL05A475MP5NRNC; LCSC C23733
C5: 100nF; C_0402_1005Metric; Manufacturer Part CL05B104KO5NNNC; LCSC C1525
C17, C18: 15pF; C_0402_1005Metric; Manufacturer Part 0402CG150J500NT; LCSC Part Name 15pF ±5% 50V
C19: 4.7uF; C_0402_1005Metric; Voltage Rated 10V; Tolerance ±20%; Part CL05A475MP5NRNC; LCSC C23733
C21, C22, C23: 100nF; C_0402_1005Metric; Voltage Rated 16V; Tolerance ±10%; Part CL05B104KO5NNNC; LCSC C1525
C24: CL10A475KO8NNNC; C_0603_1608Metric; Manufacturer Part CL10A475KO8NNNC; LCSC C19666
C37, C40: 10uF; C_0603_1608Metric; Voltage Rated 10V; Tolerance ±10%; Part CL10A106KP8NNNC; LCSC C19702
C38, C39: CL05B104KO5NNNC; C_0402_1005Metric; Manufacturer Part CL05B104KO5NNNC; LCSC C1525
D1: DFLS130L-7; D_PowerDI-123; Manufacturer Part DFLS130L-7; LCSC C110493
D2, D3: RCLAMP0521P_TCT_C3029033; Manufacturer Part RCLAMP0521P.TCT-MS; LCSC C3029033
J2: Conn_01x03_Pin; PinHeader_1x03_P2.54mm_Vertical
J4: Conn_01x64_Castellated_Pads; Castellated_Pad_64
JP1, JP2, JP3, JP4: SolderJumper_2_Open; SolderJumper-2_P1.3mm_Open_Pad1.0x1.5mm
L1: AOTA-B201610S3R3-101-T; Manufacturer Part AOTA-B201610S3R3-101-T; LCSC C42411119
PWR_LED1: KT-0603R; Manufacturer Part KT-0603R; LCSC C2286
R1, R4: 5.1kΩ; R_0402_1005Metric; Overload Voltage (Max) 50V; Tolerance ±1%; Part 0402WGF5101TCE; LCSC C25905
R2, R3: 33Ω; R_0402_1005Metric; Overload Voltage (Max) 50V; Tolerance ±1%; Part 0402WGF330JTCE; LCSC C25105
R5, R14: 1kΩ; R_0402_1005Metric; Overload Voltage (Max) 50V; Tolerance ±1%; Part 0402WGF1001TCE; LCSC C11702
R6: 33Ω; R_0402_1005Metric; Manufacturer Part 0402WGF330JTCE; LCSC Part Name 33Ω ±1% 62.5mW 厚膜电阻
R7: 1Ω; R_0402_1005Metric; Manufacturer Part 0402WGF100KTCE; LCSC C25086
R8: 200Ω; R_0402_1005Metric; Manufacturer Part 0402WGF2000TCE; LCSC C25087
R9, R10, R16: 10kΩ; R_0402_1005Metric; Overload Voltage (Max) 50V; Tolerance ±1%; Part 0402WGF1002TCE; LCSC C25744
R11: 100kΩ; R_0402_1005Metric; Overload Voltage (Max) 50V; Tolerance ±1%; Part 0402WGF1003TCE; LCSC C25741
R12: 2kΩ; R_0402_1005Metric; Overload Voltage (Max) 50V; Tolerance ±1%; Part 0402WGF2001TCE; LCSC C4109
R15: 470Ω; R_0402_1005Metric; Overload Voltage (Max) 50V; Tolerance ±1%; Part 0402WGF4700TCE; LCSC C25117
R28: 1kΩ; R_0402_1005Metric; Manufacturer Part 0402WGF1001TCE; LCSC C11702
Reset1: K2-1808SN-A4SW; Manufacturer Part K2-1808SN-A4SW-01; LCSC C92589
TP1, TP2: TestPoint; TestPoint_Pad_1.0x1.0mm
TP3, TP4, TP5: TestPoint; TestPoint_Pad_1.5x1.5mm_R0.3mm
U1: RP2350B_C42415655; Manufacturer Part RP2350B; LCSC C42415655
U3: ME6217C33M5G; SOT-23-5; Manufacturer Part ME6217C33M5G; LCSC C427602
U4: W25Q128JVSIQTR; SOIC-8_5.3x5.3mm_P1.27mm; Manufacturer Part W25Q128JVSIQ; LCSC C97521
U5: RPI Radio Module 2; rpi_rmc20452t; not fitted
U6: APS6404L-3SQR; SOIC-8_3.9x4.9mm_P1.27mm; LCSC C5333729; not fitted
USB1: TYPE-C_16PIN_2MD_073; Manufacturer Part TYPE-C 16PIN 2MD(073); LCSC C2765186
X1: ABM8-272-T3_C20625731; Manufacturer Part ABM8-272-T3; LCSC C20625731

Connections:
1V1: C2.1, C5.1, C10.1, C13.2, L1.2, TP1.1 (1_1), U1.10 (DVDD), U1.32 (DVDD), U1.51 (DVDD), U1.65 (VREG_FB)
3V3: C1.1, C3.1, C4.1, C6.1, C7.1, C8.2, C9.2, C12.1, C16.1, C21.1, C22.1, C23.1, C24.2, C36.2, C38.1, C40.2, J4.60, PWR_LED1.2 (A), R6.1, R8.2, R14.2, TP2.1 (1_1), U1.5 (IOVDD), U1.15 (IOVDD), U1.24 (IOVDD), U1.29 (IOVDD), U1.41 (IOVDD), U1.50 (IOVDD), U1.60 (IOVDD), U1.64 (VREG_VIN), U1.68 (USB_OTP_VDD), U1.69 (QSPI_IOVDD), U1.76 (IOVDD), U3.5 (VOUT), U4.8 (VCC), U5.14 (VDDIO), U5.16 (VIN), U6.8 (VCC)
3V3_EN: J4.61, R11.2, U3.3 (CE)
/VREG_LX: L1.1, U1.63 (VREG_LX)
ADC_VREF: J4.59, R7.2, R8.1
GND: Boot1.3, Boot1.4, C1.2, C2.2, C3.2, C4.2, C5.2, C6.2, C7.2, C8.1, C9.1, C10.2, C11.2, C12.2, C13.1, C15.1, C16.2, C17.2, C18.1, C19.2, C21.2, C22.2, C23.2, C24.1, C36.1, C37.2, C38.2, C39.2, C40.1, D2.1, D3.1, J2.2, J4.3, J4.8, J4.13, J4.18, J4.31, J4.34, J4.47, J4.52, J4.57, J4.62, R1.1, R4.1, R9.2, R10.2, R12.2, Reset1.3, Reset1.4, TP5.1, U1.62 (VREG_PGND), U1.81 (GND), U3.2 (VSS), U4.4 (GND), U5.1 (GND), U5.4 (GND), U5.7 (GND), U5.11 (GND), U5.15 (GND), U5.21 (GND), U6.4 (GND), USB1.1 (GND), USB1.12 (GND), USB1.13 (SHELL), USB1.14 (SHELL), X1.2 (GND), X1.4 (GND)
GPIO0: J4.1, JP1.2 (B), U1.77 (GPIO0)
GPIO1: J4.2, U1.78 (GPIO1)
GPIO2: J4.4, U1.79 (GPIO2)
GPIO3: J4.5, U1.80 (GPIO3)
GPIO4: J4.6, U1.1 (GPIO4)
GPIO5: J4.7, U1.2 (GPIO5)
GPIO6: J4.9, U1.3 (GPIO6)
GPIO7: J4.10, U1.4 (GPIO7)
GPIO8: J4.11, U1.6 (GPIO8)
GPIO9: J4.12, U1.7 (GPIO9)
GPIO10: J4.14, U1.8 (GPIO10)
GPIO11: J4.15, U1.9 (GPIO11)
GPIO12: J4.16, U1.11 (GPIO12)
GPIO13: J4.17, U1.12 (GPIO13)
GPIO14: J4.19, U1.13 (GPIO14)
GPIO15: J4.20, U1.14 (GPIO15)
GPIO16: J4.45, U1.16 (GPIO16)
GPIO17: J4.46, U1.17 (GPIO17)
GPIO18: J4.48, U1.18 (GPIO18)
GPIO19: J4.49, U1.19 (GPIO19)
GPIO20: J4.50, U1.20 (GPIO20)
GPIO21: J4.51 (Pin_61), U1.21 (GPIO21)
GPIO22: J4.53, U1.22 (GPIO22)
GPIO23: J4.21, JP3.1 (A), U1.23 (GPIO23)
GPIO24: J4.22, R15.2, R16.1, U1.25 (GPIO24), U5.5 (DI)
GPIO25: J4.23, JP2.2 (B), U1.26 (GPIO25)
GPIO26: J4.55, U1.27 (GPIO26)
GPIO27: J4.56, U1.28 (GPIO27)
GPIO28: J4.58, U1.36 (GPIO28)
GPIO29: J4.24, U1.37 (GPIO29), U5.3 (SCLK)
GPIO30: J4.25, U1.38 (GPIO30)
GPIO31: J4.26, U1.39 (GPIO31)
GPIO32: J4.27, U1.40 (GPIO32)
GPIO33: J4.28, U1.42 (GPIO33)
GPIO34: J4.29, U1.43 (GPIO34)
GPIO35: J4.30, U1.44 (GPIO35)
GPIO36: J4.32, U1.45 (GPIO36)
GPIO37: J4.33, U1.46 (GPIO37)
GPIO38: J4.35, U1.47 (GPIO38)
GPIO39: J4.36, U1.48 (GPIO39)
GPIO40/ADC0: J4.37, U1.49 (GPIO40_ADC0)
GPIO41/ADC1: J4.38, U1.52 (GPIO41_ADC1)
GPIO42/ADC2: J4.39, U1.53 (GPIO42_ADC2)
GPIO43/ADC3: J4.40, U1.54 (GPIO43_ADC3)
GPIO44/ADC4: J4.41, U1.55 (GPIO44_ADC4)
GPIO45/ADC5: J4.42, U1.56 (GPIO45_ADC5)
GPIO46/ADC6: J4.43, U1.57 (GPIO46_ADC6)
GPIO47/ADC7: J4.44, JP4.2 (B), U1.58 (GPIO47_ADC7)
unnamed: Boot1.1, Boot1.2, R5.1
unnamed: C17.1, R28.1, X1.3
unnamed: JP1.1 (A), JP4.1 (A), R14.1, U6.1 (~CE)
unnamed: JP2.1 (A), R9.1, U5.9 (CS)
unnamed: JP3.2 (B), R10.1, U5.12 (WL_ON), U5.13 (BT_ON)
unnamed: PWR_LED1.1 (K), R12.1
unnamed: C19.1, R7.1, U1.59 (ADC_AVDD)
unnamed: R5.2, U1.75 (QSPI_SS), U4.1 (CS#)
unnamed: C11.1, R6.2, U1.61 (VREG_AVDD)
unnamed: C18.2, U1.30 (XIN), X1.1
unnamed: R28.2, U1.31 (XOUT)
unnamed: R15.1, U5.6 (DO)
unnamed: R16.2, U5.10 (nIRQ)
unnamed: R1.2, USB1.4 (CC1)
unnamed: R4.2, USB1.10 (CC2)
QSPI_SCLK: U1.71 (QSPI_SCLK), U4.6 (CLK), U6.6 (SCLK)
QSPI_SD0: U1.72 (QSPI_SD0), U4.5 (DI), U6.5 (SI/SIO)
QSPI_SD1: U1.74 (QSPI_SD1), U4.2 (DO), U6.2 (SO/SIO)
QSPI_SD2: U1.73 (QSPI_SD2), U4.3 (IO2), U6.3 (SIO2)
QSPI_SD3: U1.70 (QSPI_SD3), U4.7 (IO3), U6.7 (SIO3)
RUN: C15.2, J4.54, Reset1.2, U1.35 (RUN)
SWCLK: J2.1, U1.33 (SWCLK)
SWDIO: J2.3, U1.34 (SWDIO)
USB2_D+: D3.2, R3.2, TP4.1, USB1.6 (DP1), USB1.8 (DP2)
USB2_D-: D2.2, R2.2, TP3.1, USB1.5 (DN2), USB1.7 (DN1)
USB_D+: R3.1, U1.67 (USB_D+)
USB_D-: R2.1, U1.66 (USB_D-)
VBUS: D1.2, J4.64, USB1.2 (VBUS), USB1.11 (VBUS)
VSYS: C37.1, C39.1, D1.1, J4.63, R11.1, U3.1 (VIN)

Notes on the sheet:
Clock
PSRAM
USB Type C
Flash
3.3V Power
Radio Module 2
Debug
Run button
Pico Stretch RP2350B Devboard
Inductor layout and wiring should be consistent with design guidelines
1V1 Power
Pads
Adapted from an EasyEDA open source design: https://pro.easyeda.com/editor#id=a0a21c97b13d436db5579fc2a8b1625d and the Raspberry Pi Pico hardware design guide and reference designs. Part recommendations for the inductor, flash and clock crystal were followed.
800mA

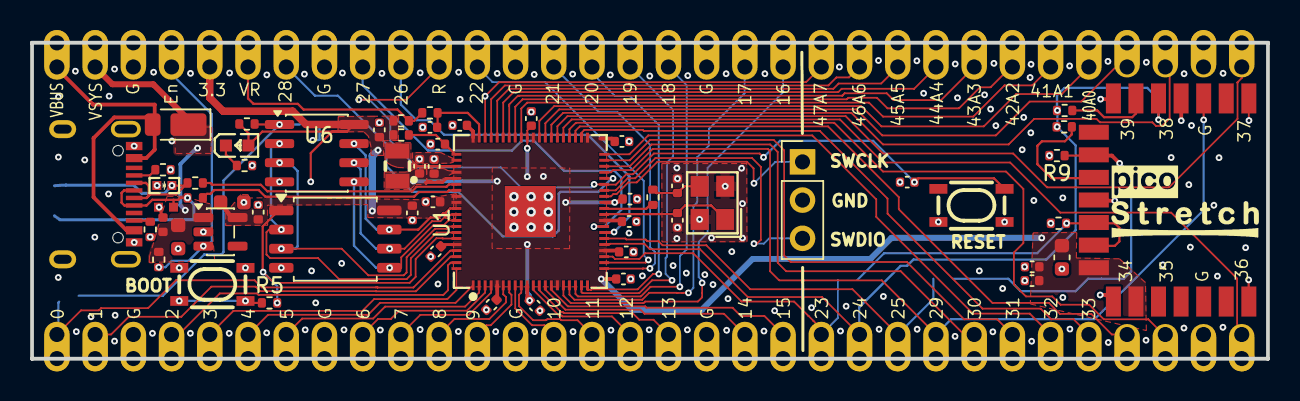
[picture p39: board pico-stretch2.kicad_pcb from above]

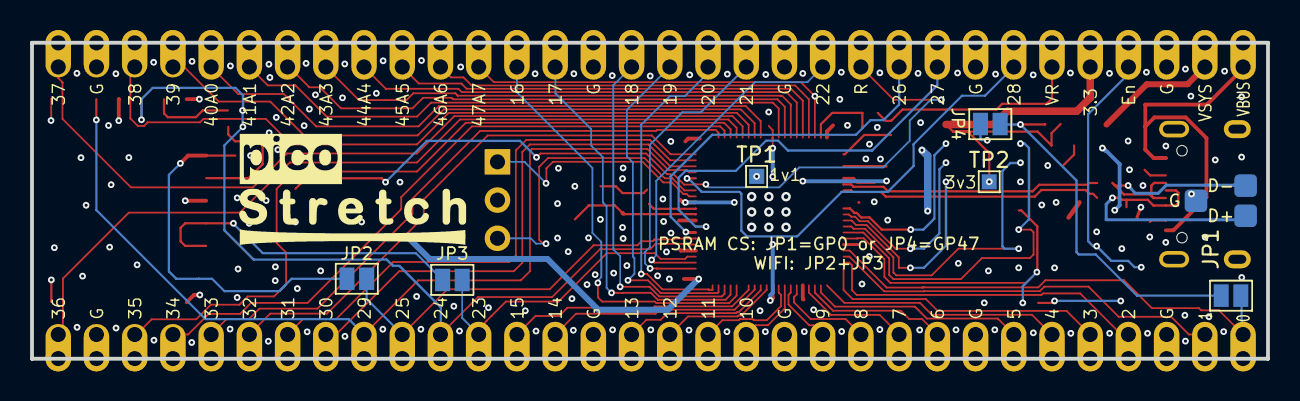
[picture p40: board pico-stretch2.kicad_pcb from below]

Board: 4 copper layers, 82.1 x 21.0 mm, 68 parts (9 on the bottom side), 83 nets.
