jvanderberg/pico-stretch2/(commit log)

2026-05-18 Initial commit: Pico Stretch 2 RP2350B dev board
2026-10-29 Carry over pico-stretch review fixes
    - U6 PSRAM is now APS6404L-3SQR (C5333729, 3.3 V); ESP-PSRAM32 is a 1.8 V part. Marked DNP, Exclude DNP on
    - LCSC C1525 on C3/C4/C6 (the BOM rows had no part number)
    - Silk ADC labels fixed (47A7..41A1); stray line breaks removed from "44A3" and "21"
    - Courtyards on U1, USB1, X1, L1, D2, D3, Boot1, Reset1, PWR_LED1 and J4 (board and project libraries);
    tight pairs as built exempted by name in pico-stretch2.kicad_dru
    - Stackup set to JLC04161H-7628
    - Project copies of the symbol libraries the schematic uses (libs/, RPI_RMC20452T.kicad_sym, 15 pF in
    EasyEDA.kicad_sym); J2 model path on KICAD10_3DMODEL_DIR; stray power-symbol footprint fields cleared
    - R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
2026-10-29 Inner1 cut-out under the VREG_LX node
    RP2350 datasheet 6.3.8.1 / Figure 27: no copper on layer 2 under LX. Rule area covers the VREG_LX pour,
    L1's LX pad and the LX trace to U1 pin 63; CIN/COUT GND vias stay on solid plane. Zones refilled.
2026-10-29 USB test pads, PSRAM CS on GPIO0 or GPIO47, back-side pin labels
    - TP3 (USB D-) and TP4 (USB D+) on the back, connector side of R2/R3; new via in D2's signal pad for D-
    - JP4 (back, beside U6) selects GPIO47 as the PSRAM chip select; JP1 still selects GPIO0. GPIO47 reaches
    JP4 on a 0.15 mm Inner2 track from castellated pad 44 along y 94.05 (back-layer traces only cross it,
    every via 0.42 mm or more away) and one via; JP4 sits at the PSRAM end so an open JP4 leaves no stub
    - Every castellated pad labelled on the back (same text as the front); D-/D+ beside the test pads;
    jumper note moved off TP4 and rewritten for JP4; back logo moved down 2.9 mm to clear the labels
    - README: PSRAM jumpe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
2026-10-29 Join JP4's GPIO47 link near U1 instead of at pad 44
    The Inner2 link from JP4 ran 34 mm along y 94.05 to castellated pad 44, slitting
    the Inner2 ground plane under ten back-side GPIO traces (GP16-22, GP26-28) and
    crossing the Pico-footprint cut line. It now drops onto U1's GPIO47 front track at
    its corner (139.26, 94.54): Inner2 run 37.3 -> 14.5 mm, crossed only by GP26-28,
    and nothing crosses the cut line.
    Also ignore KiCad's automatic project backups.
2026-10-29 Move JP4's GPIO47 link from Inner2 to Inner1
    On Inner2 it slit the reference plane under the back-side GP26, GP27 and GP28
    traces. On Inner1 the only front traces crossing it are 3V3, RUN and ADC_VREF,
    all static, so no fast signal loses its reference; Inner2 is now unbroken.
    Same path and vias.
2026-10-29 Apply design review fixes and add re-review
    Review 1 fixes (scripts/review_fixes.py, rebuilds from 54e971f):
    - C9/C15 to 0402 C1525, R14 to 1k, C40 to 0603 10 uF with via-in-pad
    - D3 in line on USB D+, C39 flipped to share D3 ground via
    - C13 moved 0.05 mm clear of U1 pin 50
    - Extended In1 VREG_LX cut-out, J4 pads 29-36 clipped
    - U5 DNP with no paste, silkscreen fixes, named courtyard pairs
    - VBUS TVS tried and removed
    DESIGN_REVIEW_2.md and review2/ hold the re-review and its pack.
2026-10-31 Design review 3 fixes and Pico-footprint USB test pads
    Review 3 (DESIGN_REVIEW_3.md, scripts/review3_fixes.py, from 1d4354a):
    - 87 vias 0.4/0.2 -> 0.45/0.2 (JLC's free via); Default net class and
    DRC minimum via 0.45 mm; 0.45 mm via-to-plated-hole rule, hole_to_hole
    an error
    - VREG_LX track 0.18 mm beside C10/C12 (JLC 0.1 mm pad-to-track)
    - C2/C5 values swapped: 4.7 uF on DVDD pin 32, the pin furthest from
    the regulator (RP2350 datasheet 6.1.3)
    - C9, RUN and GPIO47 vias moved off / into their own pads
    USB test pads at the Pico 2's TP1-TP3 positions (scripts/pico_testpads.py),
    so the board can be hot-plate soldered onto a Pico SMT footprint:
    - TP3 (D-), TP4 (D+) and new TP5 (GND) on 1.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
2026-10-31 JLCImport production files, fresh README images, copper parts out of BOM/CPL
    - production/: Fabrication Toolkit output and its options file removed;
    JLCImport (jlcimport-cli production) gerbers, BOM, CPL and report
    regenerated from the current board
    - TP1-TP5 and J4 (copper only) excluded from the BOM and position files,
    as JP1-JP4 already are, so no blank BOM rows and no bottom-side CPL
    entries (scripts/pico_testpads.py; Castellated_Pad_64 and the Pico
    test-pad footprint carry the same attributes)
    - images/: all README renders regenerated (scripts/render-images.sh)
    - README: production section describes the JLCImport files
